airzone-sama/polargraph/wiki/images/setup tab.jpg

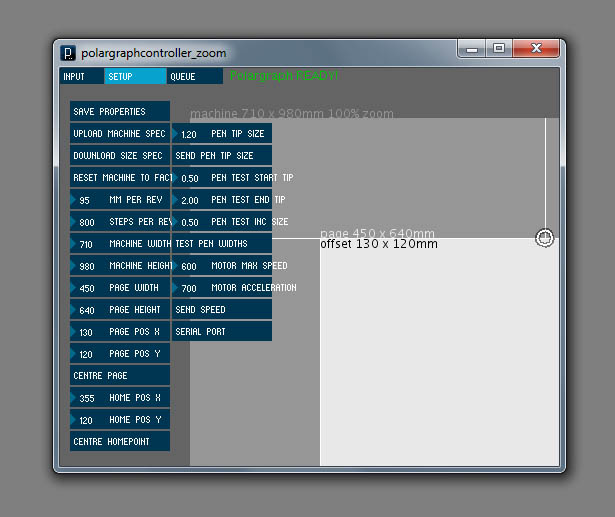
wiki/images/setup tab.jpg
