airzone-sama/polargraph/wiki/images/interface with labels.jpg

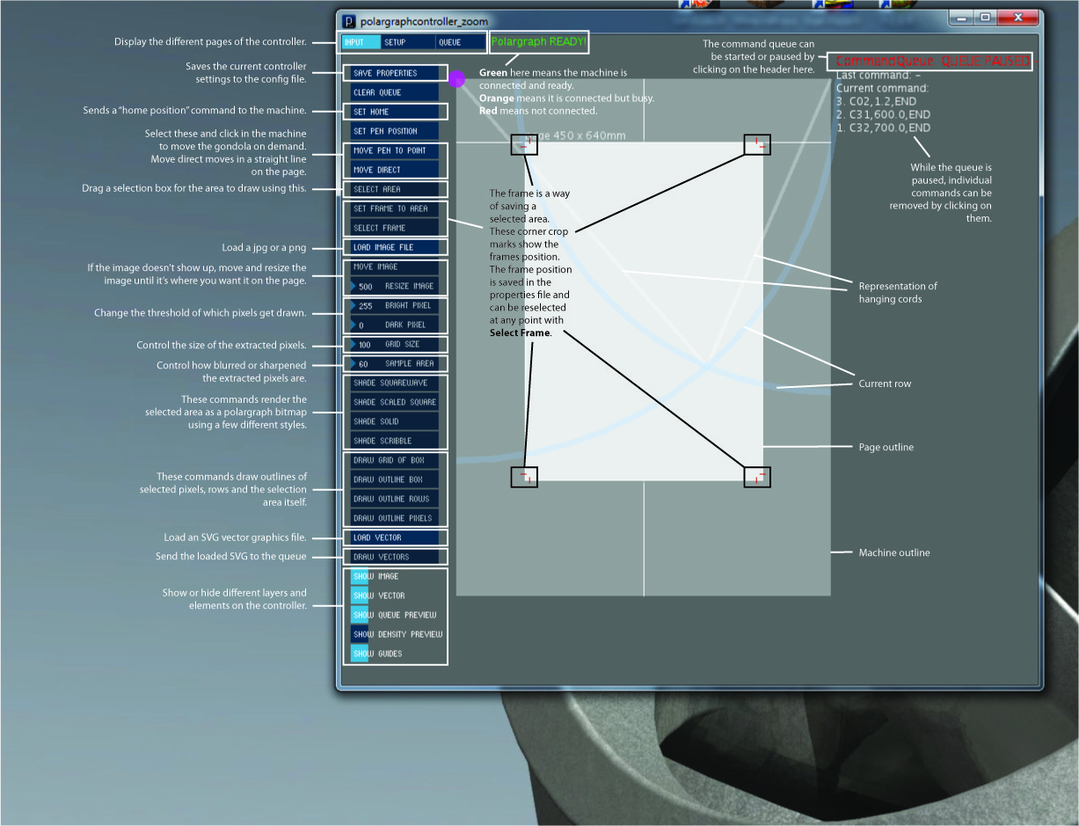
wiki/images/interface with labels.jpg
