airzone-sama/polargraph/hardware/polarshield v1.2 2012.11.02.htm

Partlist exported from C:/Users/sandy/Documents/eagle/Polarshield1.5/polarshield v1.2 2012.11.02.sch at 02/11/2012 22:22:55

Part | Value | Device | Package | Description
AUX3 | M04X2 | M04X2 | 2X4
C1 | 10uF | CPOL-EUCT3528 | CT3528 | POLARIZED CAPACITOR, European symbol
C2 | 100nF | C-EUC0805 | C0805 | CAPACITOR, European symbol
C3 | 100uF | CPOL-EU153CLV-0605 | 153CLV-0605 | POLARIZED CAPACITOR, European symbol
C4 | 100uF | CPOL-EU153CLV-0605 | 153CLV-0605 | POLARIZED CAPACITOR, European symbol
C5 | 10uF | CPOL-EUCT3528 | CT3528 | POLARIZED CAPACITOR, European symbol
C6 | 100uF | CPOL-EU153CLV-0605 | 153CLV-0605 | POLARIZED CAPACITOR, European symbol
C7 | 100nF | C-EUC0805 | C0805 | CAPACITOR, European symbol
CN1 | 1X4-CLEANBIG | 1X4-CLEANBIG | 1X04-CLEANBIG | 4-pin connector
CN2 | 1X4-CLEANBIG | 1X4-CLEANBIG | 1X04-CLEANBIG | 4-pin connector
D13 | | LEDCHIP-LED0805 | CHIP-LED0805 | LED
EXT_PWR | | JP1Q | JP1 | JUMPER
I2C | | PINHD-1X4 | 1X04 | PIN HEADER
IC1 | LMV358MMX | LMV358MMX | MSOP08 | Dual General Purpose, Low Voltage, Rail-to-Rail Output Operational Amplifiers
IC2 | MC33269D-3.3 | MC33269D-3.3 | DPACK | Adjustable Output Low Dropout Voltage Regulator 800 mA
J1 | 1X2-3.5MM | 1X2-3.5MM | 1X2-3.5MM | 3.5mm Terminal block
JP1 | | PINHD-1X8CLEANBIG | 1X08-CLEANBIG | PIN HEADER
JP2 | | M04SCREW | SCREWTERMINAL-3.5MM-4 | Header 4
JP3 | | PINHD-1X8CLEANBIG | 1X08-CLEANBIG | PIN HEADER
JP4 | | PINHD-2X3 | 2X03 | PIN HEADER
JP5 | | PINHD-2X3 | 2X03 | PIN HEADER
JP6 | | PINHD-2X20 | 2X20 | PIN HEADER
JP7 | | M04SCREW | SCREWTERMINAL-3.5MM-4 | Header 4
JP8 | | PINHD-1X8CLEANBIG | 1X08-CLEANBIG | PIN HEADER
JP9 | | PINHD-1X8CLEANBIG | 1X08-CLEANBIG | PIN HEADER
JP10 | | PINHD-1X8CLEANBIG | 1X08-CLEANBIG | PIN HEADER
JP11 | | PINHD-1X6CB | 1X06-CLEANBIG | PIN HEADER
JP12 | | PINHD-1X3CB | 1X03-CLEANBIG | PIN HEADER
JP13 | | PINHD-1X3CB | 1X03-CLEANBIG | PIN HEADER
JP14 | | PINHD-1X1CB | 1X01-CLEANBIG | Pin header 1x1 for 0.1" spacing
POWER | | LEDCHIP-LED0805 | CHIP-LED0805 | LED
PWR | RED | LEDCHIPLED_0805 | CHIPLED_0805 | LED
R1 | 10k | R-EU_R0805 | R0805 | RESISTOR, European symbol
R2 | 15k | R-EU_R0805 | R0805 | RESISTOR, European symbol
R5 | 100k | R-EU_R0805 | R0805 | RESISTOR, European symbol
R8 | 100k | R-EU_R0805 | R0805 | RESISTOR, European symbol
R12 | 1K | R-EU_R0805 | R0805 | RESISTOR, European symbol
R13 | 10 | R-EU_R0805 | R0805 | RESISTOR, European symbol
R18 | 10k | R-EU_R0805 | R0805 | RESISTOR, European symbol
R19 | 10k | R-EU_R0805 | R0805 | RESISTOR, European symbol
R21 | 4.7K | R-EU_R0805 | R0805 | RESISTOR, European symbol
R22 | 4.7K | R-EU_R0805 | R0805 | RESISTOR, European symbol
R26 | 10 | R-EU_R0805 | R0805 | RESISTOR, European symbol
R41 | 1K | R-EU_R0805 | R0805 | RESISTOR, European symbol
RN1 | 10K | 4R-NEXBS8V | EXBS8V | Array Chip Resistor
RN2 | 10K | 4R-NEXBS8V | EXBS8V | Array Chip Resistor
RN3 | 10K | 4R-NEXBS8V | EXBS8V | Array Chip Resistor
RN4 | 10K | 4R-NEXBS8V | EXBS8V | Array Chip Resistor
RN5 | 10K | 4R-NEXBS8V | EXBS8V | Array Chip Resistor
RN6 | 1K | 4R-NEXBS8V | EXBS8V | Array Chip Resistor
RSSI | YELLOW | LEDCHIPLED_0805 | CHIPLED_0805 | LED
RX | GRN | LEDCHIPLED_0805 | CHIPLED_0805 | LED
S2 | | TAC_SWITCHPTH | TACTILE-PTH | Momentary Switch
SER1 | | 3PIN-HEADER | 3PIN-HEADER | PIN HEADER
SER2 | | 3PIN-HEADER | 3PIN-HEADER | PIN HEADER
SW1 | JS202011AQN | JS202011AQN | JS202011AQN
TX | GRN | LEDCHIPLED_0805 | CHIPLED_0805 | LED
U$6 | A4988BREAKOUT | A4988BREAKOUT | A4988BREAKOUT
U$7 | A4988BREAKOUT | A4988BREAKOUT | A4988BREAKOUT
U1 | ARDUINO_MEGA_SHIELD | ARDUINO_MEGA_SHIELD | ARDUINO_MEGA_SHIELD
X+ | | 3PIN-HEADER | 3PIN-HEADER | PIN HEADER
X- | | 3PIN-HEADER | 3PIN-HEADER | PIN HEADER
X-MOT | | 1X4-BIG | 1X04-BIG | 4-pin connector
X1 | 2.1MMJACKTHM | 2.1MMJACKTHM | PJ-102A | 2.1mm x 5.5mm THM DC jack with internal switch. Digikey part #PJ-102A, 4UCON part #05537
XBEE | XBEE-1B2 | XBEE-1B2 | XBEE-SILK
Y+ | | 3PIN-HEADER | 3PIN-HEADER | PIN HEADER
Y- | | 3PIN-HEADER | 3PIN-HEADER | PIN HEADER
Y-MOT | | 1X4-BIG | 1X04-BIG | 4-pin connector
