airzone-sama/polargraph/ps2polar/one_motor_rev_diamond.jpg

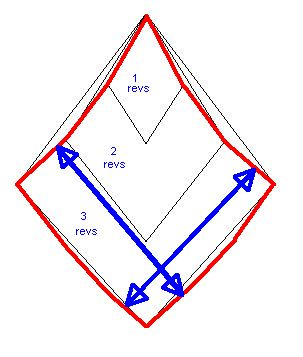
ps2polar/one_motor_rev_diamond.jpg
