airzone-sama/polargraph/ps2polar/string_art.jpg

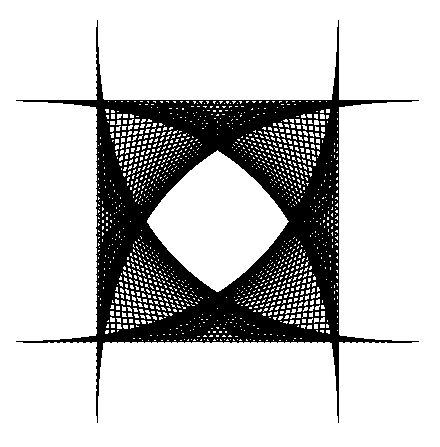
ps2polar/string_art.jpg
