airzone-sama/polargraph/wiki/images/change grid size during preview.jpg

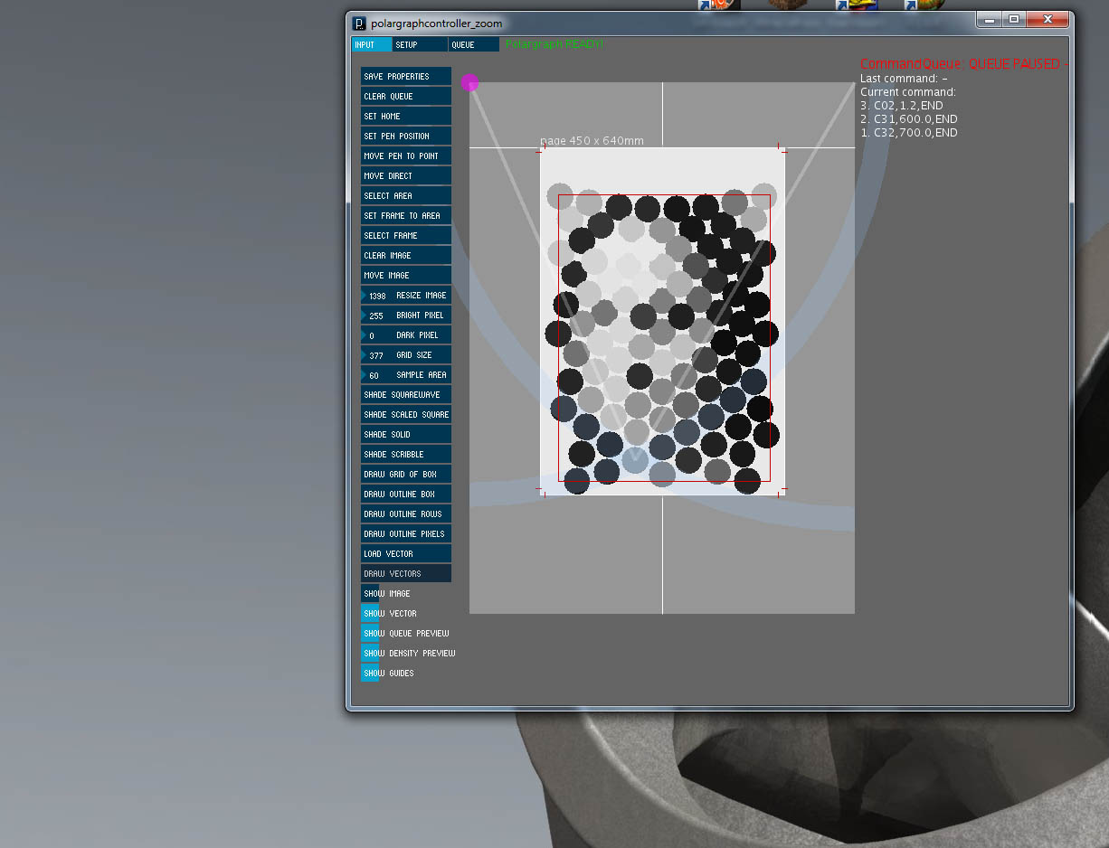
wiki/images/change grid size during preview.jpg
