airzone-sama/polargraph/wiki/images/change sample size during preview.jpg

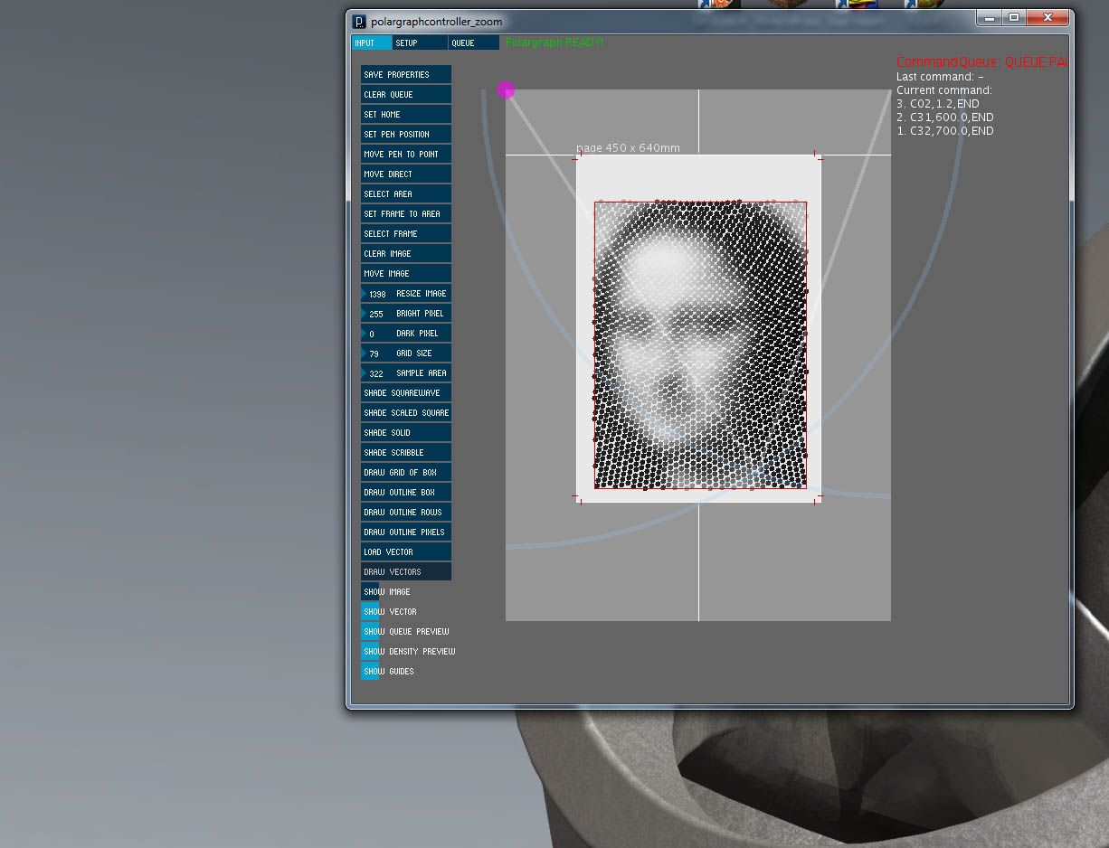
wiki/images/change sample size during preview.jpg
