airzone-sama/polargraph/wiki/images/change serial port.jpg

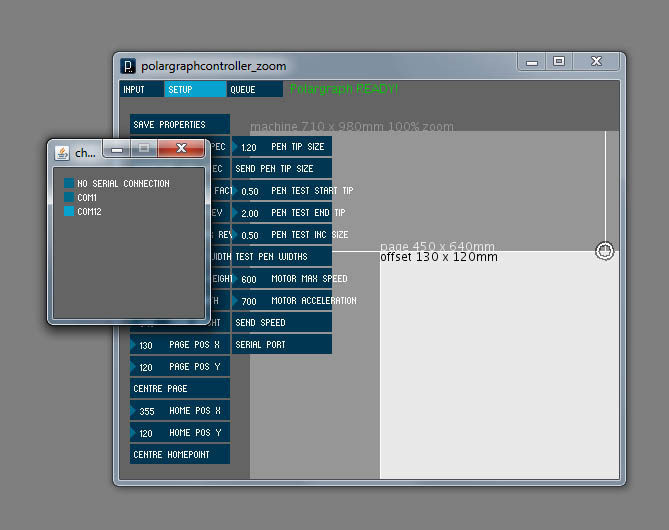
wiki/images/change serial port.jpg
