airzone-sama/polargraph/wiki/images/load vector graphics.jpg

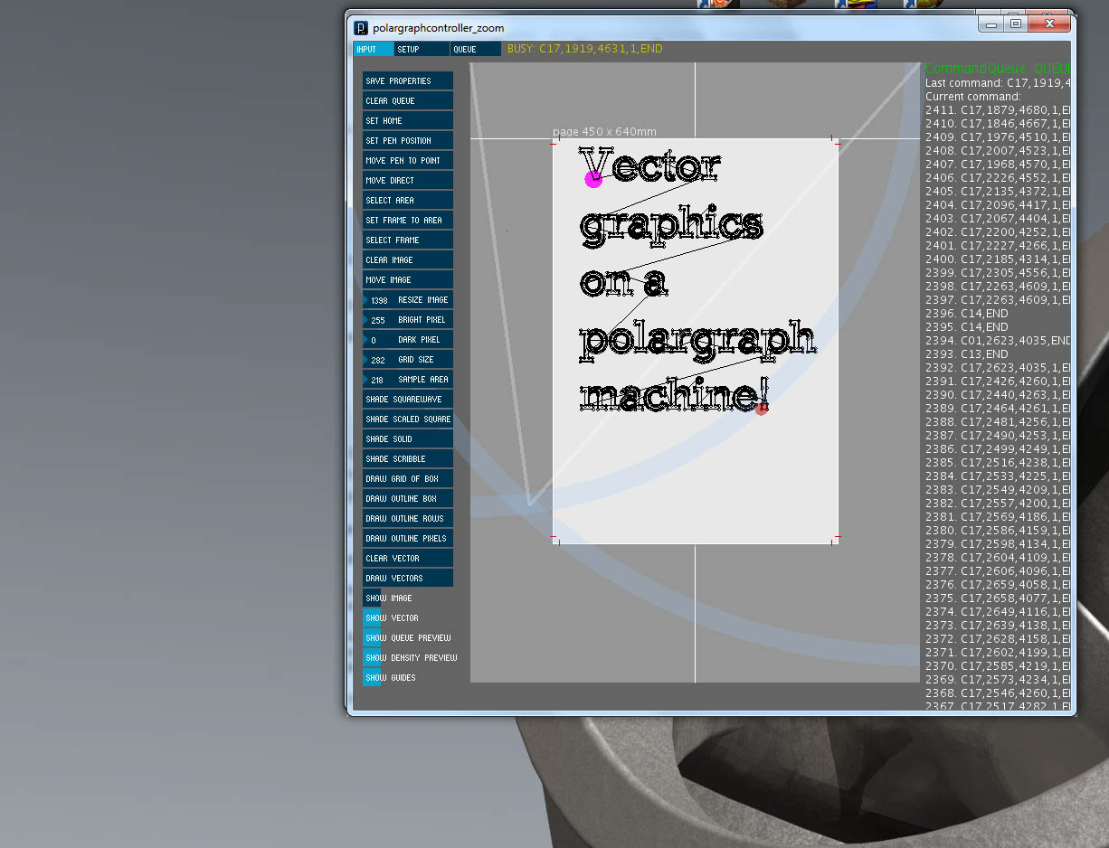
wiki/images/load vector graphics.jpg
