airzone-sama/polargraph/wiki/images/move image.jpg

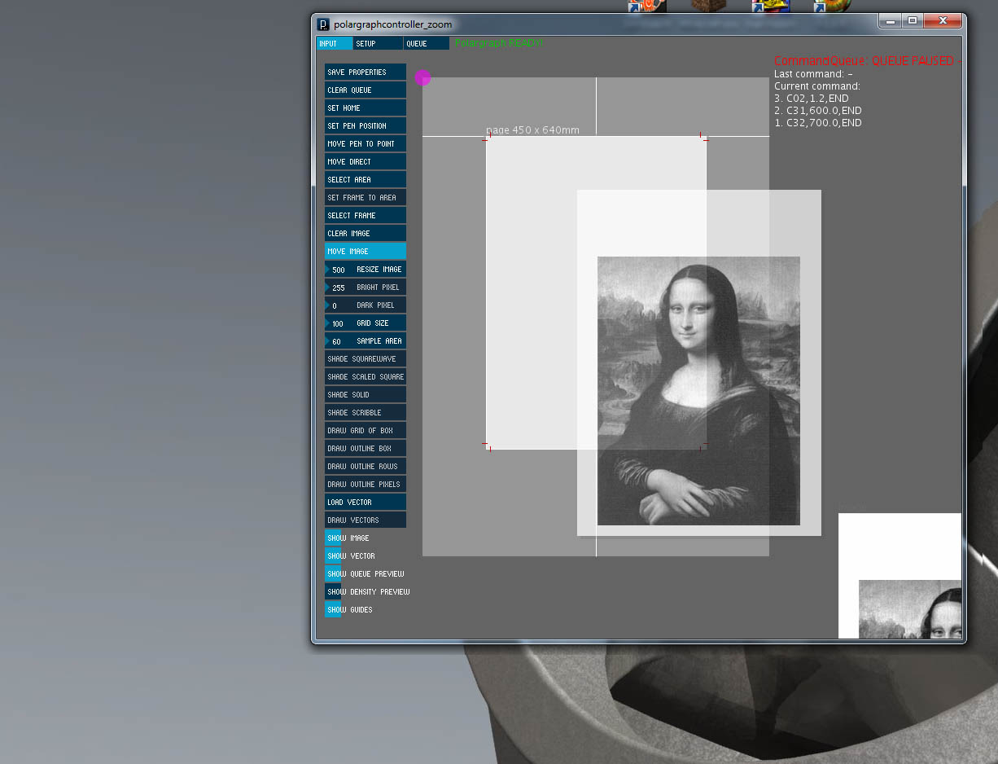
wiki/images/move image.jpg
