airzone-sama/polargraph/wiki/images/P1030602_c_r.jpg

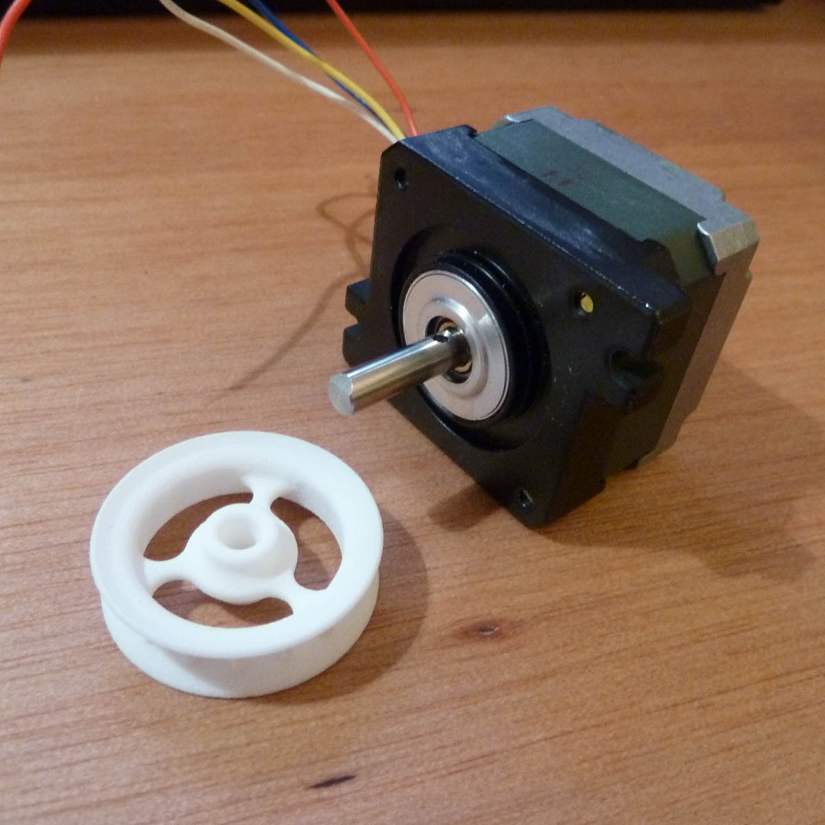
wiki/images/P1030602_c_r.jpg
