airzone-sama/polargraph/wiki/images/P1030603_c_r.jpg

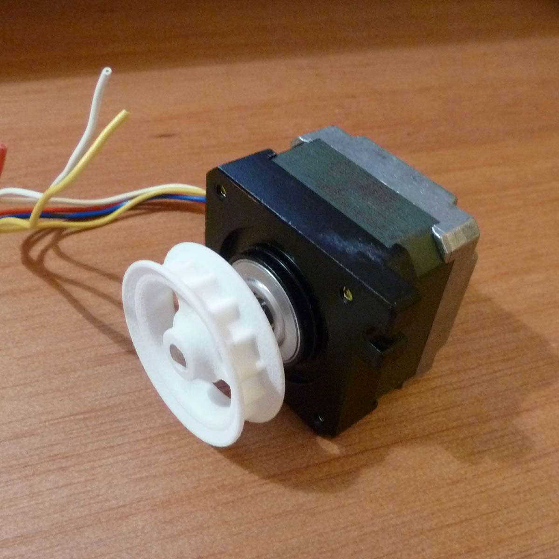
wiki/images/P1030603_c_r.jpg
