airzone-sama/polargraph/wiki/images/P1030609_c_p_r.jpg

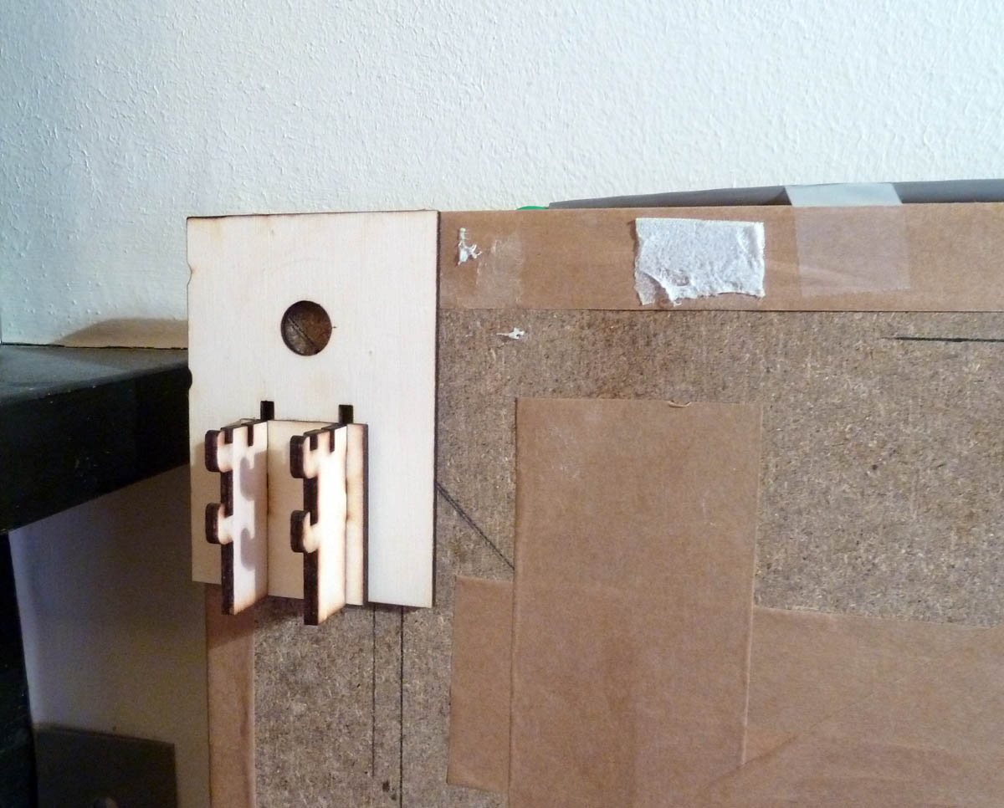
wiki/images/P1030609_c_p_r.jpg
