airzone-sama/polargraph/wiki/images/P1030670_c_r_p.jpg

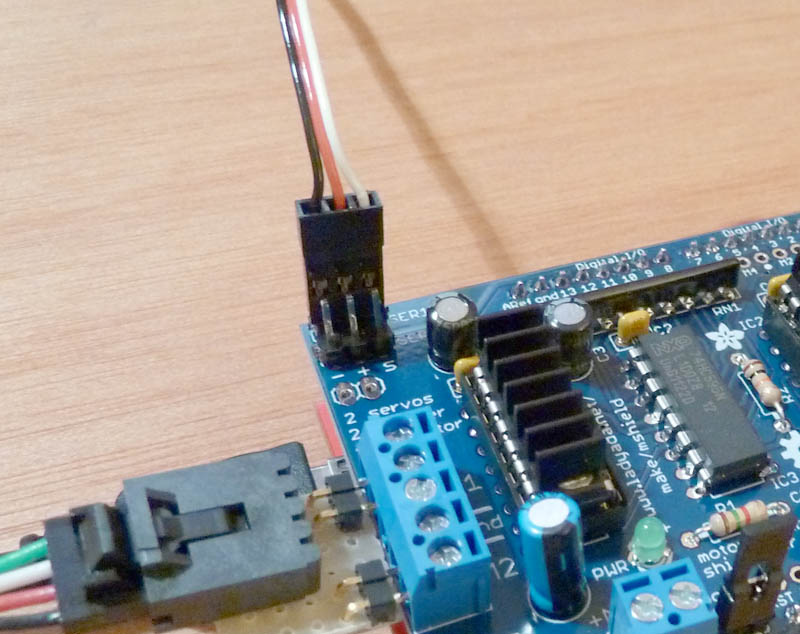
wiki/images/P1030670_c_r_p.jpg
