airzone-sama/polargraph/wiki/images/P1030677_c_p.jpg

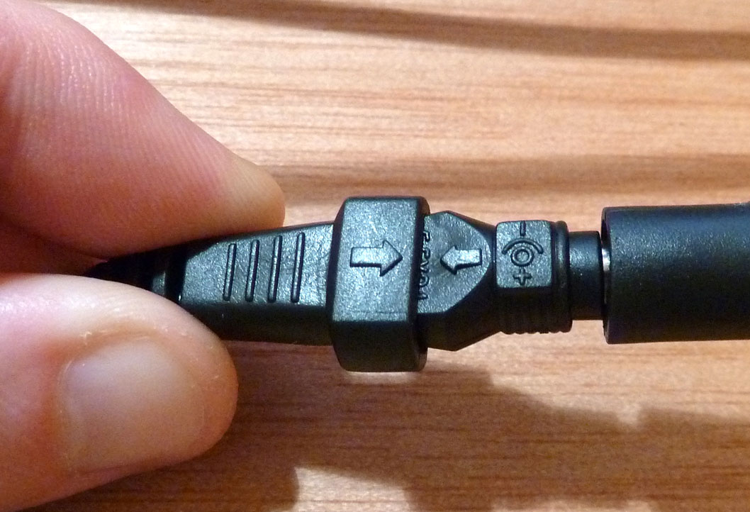
wiki/images/P1030677_c_p.jpg
