airzone-sama/polargraph/wiki/images/queue vector preview.jpg

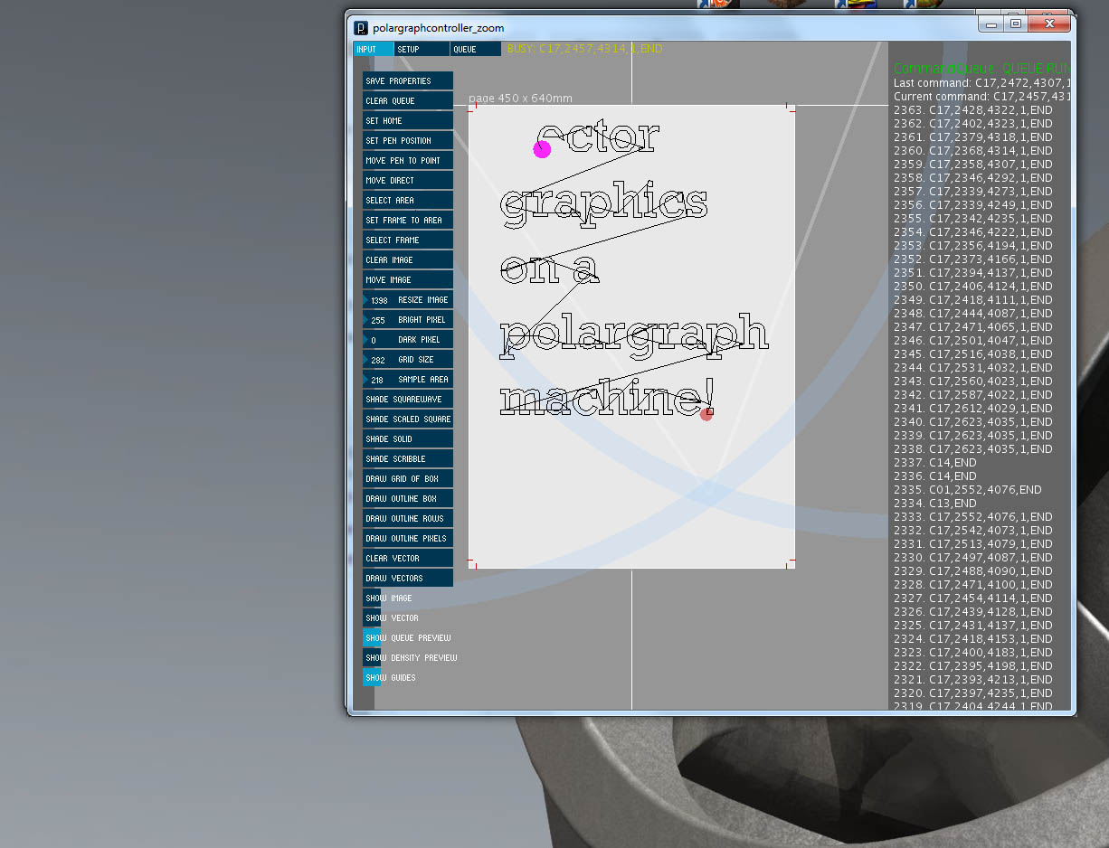
wiki/images/queue vector preview.jpg
