airzone-sama/polargraph/wiki/images/resize image during preview.jpg

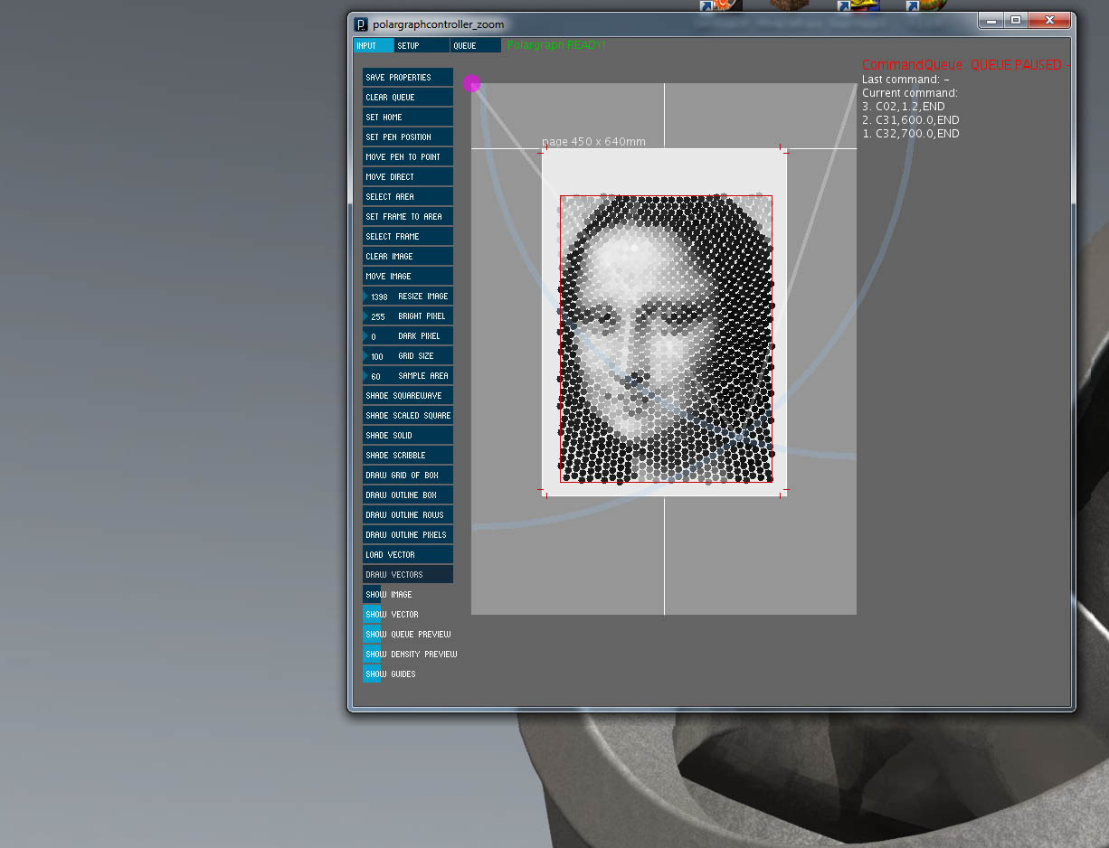
wiki/images/resize image during preview.jpg
