airzone-sama/polargraph/wiki/images/selected density preview.jpg

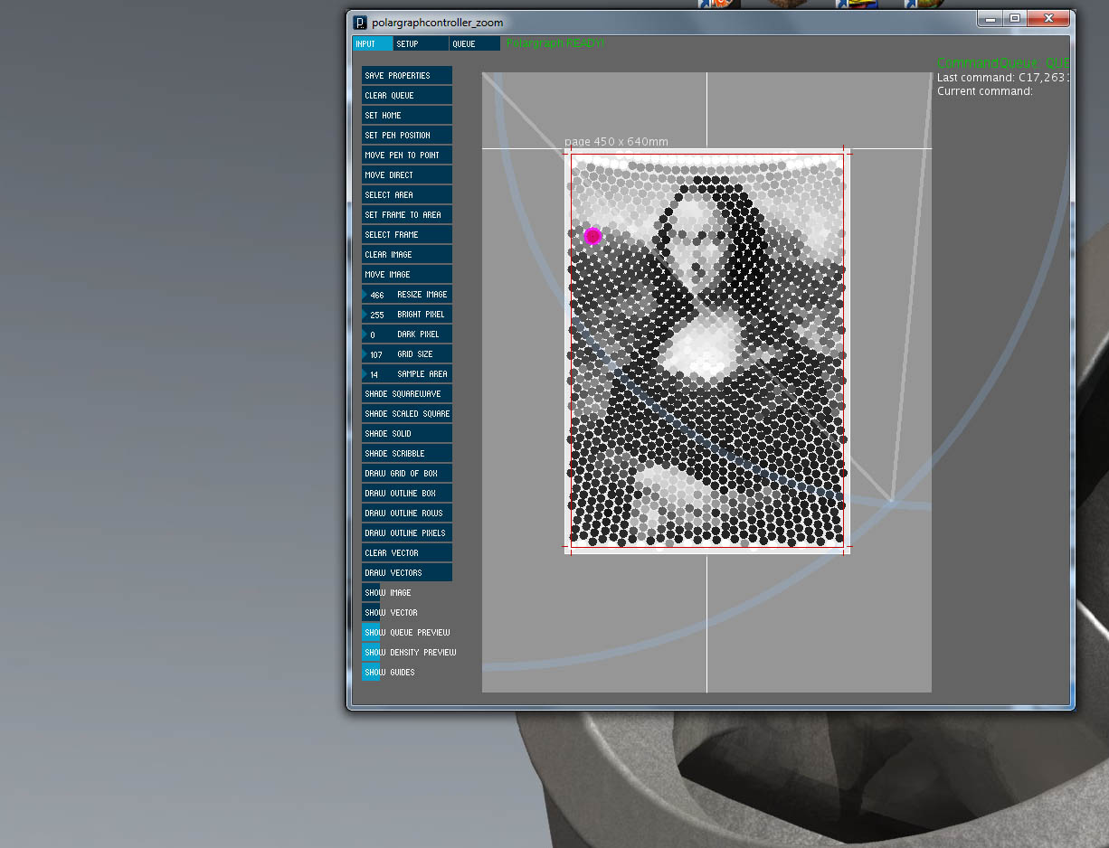
wiki/images/selected density preview.jpg
