airzone-sama/polargraph/wiki/images/startup app.jpg

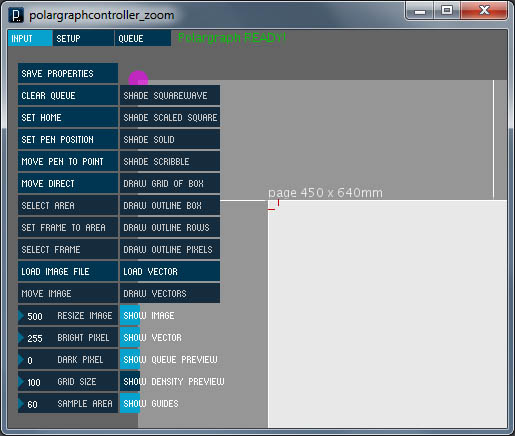
wiki/images/startup app.jpg
