airzone-sama/polargraph/wiki/SoftwareGuide.wiki

#summary How to use the controller software

= Introduction =

A quick guide about how to use the controller software.



= Details =

This is already covered in the instructable at http://www.instructables.com/id/Polargraph-Drawing-Machine/step12/Controller-software-Primer/ and the following steps.
