airzone-sama/polargraph/ps2polar/QA_show_origins_cmds.txt

C14,END
C01,7749,10257,END
C13,END
C01,7757,10239,END
C01,7764,10222,END
C01,7743,10209,END
C01,7723,10204,END
C01,7706,10206,END
C01,7696,10217,END
C01,7695,10234,END
C01,7702,10254,END
C01,7715,10274,END
C01,7735,10293,END
C01,7757,10305,END
C01,7777,10311,END
C01,7793,10308,END
C01,7803,10297,END
C01,7804,10280,END
C01,7797,10260,END
C01,7784,10240,END
C01,7764,10222,END
C14,END
C01,7326,9941,END
C13,END
C01,7334,9923,END
C01,7342,9905,END
C01,7320,9892,END
C01,7300,9888,END
C01,7284,9891,END
C01,7274,9902,END
C01,7272,9920,END
C01,7278,9940,END
C01,7291,9960,END
C01,7311,9978,END
C01,7333,9990,END
C01,7353,9995,END
C01,7369,9991,END
C01,7379,9980,END
C01,7381,9963,END
C01,7375,9943,END
C01,7361,9923,END
C01,7342,9905,END
C14,END
C01,2777,7271,END
C13,END
C01,2798,7246,END
C01,2819,7221,END
C01,2803,7220,END
C01,2783,7226,END
C01,2763,7240,END
C01,2744,7258,END
C01,2731,7279,END
C01,2725,7298,END
C01,2726,7312,END
C01,2736,7321,END
C01,2753,7322,END
C01,2772,7315,END
C01,2792,7302,END
C01,2811,7284,END
C01,2824,7263,END
C01,2830,7244,END
C01,2828,7230,END
C01,2819,7221,END
C14,END
C01,10325,7722,END
C13,END
C01,10343,7715,END
C01,10361,7708,END
C01,10343,7688,END
C01,10322,7674,END
C01,10302,7667,END
C01,10285,7669,END
C01,10274,7678,END
C01,10271,7694,END
C01,10276,7714,END
C01,10289,7736,END
C01,10307,7756,END
C01,10328,7770,END
C01,10348,7776,END
C01,10365,7775,END
C01,10376,7766,END
C01,10378,7750,END
C01,10373,7730,END
C01,10361,7708,END
C14,END
C01,10011,7297,END
C13,END
C01,10030,7290,END
C01,10048,7282,END
C01,10030,7263,END
C01,10010,7249,END
C01,9990,7242,END
C01,9973,7244,END
C01,9961,7254,END
C01,9958,7270,END
C01,9962,7291,END
C01,9974,7312,END
C01,9992,7332,END
C01,10012,7345,END
C01,10033,7352,END
C01,10050,7350,END
C01,10061,7340,END
C01,10065,7324,END
C01,10060,7304,END
C01,10048,7282,END
C14,END
C01,7366,2700,END
C13,END
C01,7391,2679,END
C01,7417,2659,END
C01,7408,2649,END
C01,7393,2647,END
C01,7374,2652,END
C01,7354,2666,END
C01,7335,2684,END
C01,7322,2705,END
C01,7315,2724,END
C01,7316,2740,END
C01,7325,2750,END
C01,7340,2752,END
C01,7358,2747,END
C01,7379,2734,END
C01,7397,2716,END
C01,7411,2696,END
C01,7417,2676,END
C01,7417,2659,END
C14,END
C01,7913,9908,END
C13,END
C01,7922,9891,END
C01,7931,9874,END
C01,7909,9861,END
C01,7889,9855,END
C01,7872,9857,END
C01,7861,9867,END
C01,7858,9883,END
C01,7864,9903,END
C01,7876,9924,END
C01,7895,9942,END
C01,7917,9956,END
C01,7937,9962,END
C01,7954,9960,END
C01,7965,9950,END
C01,7968,9933,END
C01,7962,9913,END
C01,7950,9893,END
C01,7931,9874,END
C14,END
C01,6824,3610,END
C13,END
C01,6849,3589,END
C01,6873,3569,END
C01,6862,3559,END
C01,6846,3557,END
C01,6827,3563,END
C01,6806,3576,END
C01,6789,3594,END
C01,6777,3615,END
C01,6772,3634,END
C01,6775,3650,END
C01,6786,3660,END
C01,6803,3662,END
C01,6822,3657,END
C01,6842,3644,END
C01,6860,3626,END
C01,6871,3605,END
C01,6876,3586,END
C01,6873,3569,END
C14,END
