airzone-sama/polargraph/ps2polar/QA_string_art_C17cmds.txt

C14,END
C17,4552,6090,20,END
C13,END
C17,6431,7597,20,END
C14,END
C17,4584,6113,20,END
C13,END
C17,6461,7560,20,END
C14,END
C17,4615,6137,20,END
C13,END
C17,6492,7522,20,END
C14,END
C17,4648,6161,20,END
C13,END
C17,6522,7485,20,END
C14,END
C17,4680,6186,20,END
C13,END
C17,6554,7448,20,END
C14,END
C17,4713,6211,20,END
C13,END
C17,6585,7411,20,END
C14,END
C17,4747,6237,20,END
C13,END
C17,6617,7375,20,END
C14,END
C17,4781,6262,20,END
C13,END
C17,6649,7338,20,END
C14,END
C17,4815,6288,20,END
C13,END
C17,6681,7302,20,END
C14,END
C17,4849,6315,20,END
C13,END
C17,6713,7266,20,END
C14,END
C17,4884,6342,20,END
C13,END
C17,6746,7230,20,END
C14,END
C17,4920,6369,20,END
C13,END
C17,6779,7194,20,END
C14,END
C17,4956,6397,20,END
C13,END
C17,6812,7159,20,END
C14,END
C17,4992,6425,20,END
C13,END
C17,6845,7124,20,END
C14,END
C17,5028,6453,20,END
C13,END
C17,6879,7089,20,END
C14,END
C17,5065,6482,20,END
C13,END
C17,6913,7054,20,END
C14,END
C17,5102,6511,20,END
C13,END
C17,6947,7019,20,END
C14,END
C17,5140,6541,20,END
C13,END
C17,6981,6985,20,END
C14,END
C17,5177,6570,20,END
C13,END
C17,7015,6950,20,END
C14,END
C17,5215,6600,20,END
C13,END
C17,7050,6916,20,END
C14,END
C17,5254,6631,20,END
C13,END
C17,7085,6882,20,END
C14,END
C17,5293,6661,20,END
C13,END
C17,7120,6849,20,END
C14,END
C17,5332,6692,20,END
C13,END
C17,7155,6815,20,END
C14,END
C17,5371,6724,20,END
C13,END
C17,7191,6782,20,END
C14,END
C17,5410,6755,20,END
C13,END
C17,7226,6749,20,END
C14,END
C17,5450,6787,20,END
C13,END
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
C14,END
C17,5114,6219,20,END
C13,END
C17,6794,7907,20,END
C14,END
C17,5074,6264,20,END
C13,END
C17,6840,7947,20,END
C14,END
C17,5035,6308,20,END
C13,END
C17,6887,7987,20,END
C14,END
C17,4995,6352,20,END
C13,END
C17,6933,8027,20,END
C14,END
C17,4956,6397,20,END
C13,END
C17,6980,8067,20,END
C14,END
