airzone-sama/polargraph/ps2polar/QA_string_art_cmds.txt

C14,END
C01,4552,6090,END
C13,END
C01,4576,6107,END
C01,4599,6125,END
C01,4622,6142,END
C01,4646,6160,END
C01,4670,6178,END
C01,4694,6197,END
C01,4719,6215,END
C01,4744,6234,END
C01,4768,6253,END
C01,4794,6272,END
C01,4819,6292,END
C01,4845,6311,END
C01,4870,6331,END
C01,4896,6351,END
C01,4923,6371,END
C01,4949,6392,END
C01,4976,6412,END
C01,5002,6433,END
C01,5029,6454,END
C01,5056,6475,END
C01,5084,6497,END
C01,5111,6518,END
C01,5139,6540,END
C01,5167,6562,END
C01,5195,6584,END
C01,5223,6606,END
C01,5251,6629,END
C01,5280,6651,END
C01,5309,6674,END
C01,5338,6697,END
C01,5367,6720,END
C01,5396,6744,END
C01,5425,6767,END
C01,5455,6791,END
C01,5484,6815,END
C01,5514,6839,END
C01,5544,6863,END
C01,5574,6887,END
C01,5604,6912,END
C01,5634,6936,END
C01,5665,6961,END
C01,5695,6986,END
C01,5726,7011,END
C01,5757,7036,END
C01,5788,7061,END
C01,5819,7087,END
C01,5850,7113,END
C01,5882,7138,END
C01,5913,7164,END
C01,5945,7190,END
C01,5976,7217,END
C01,6008,7243,END
C01,6040,7269,END
C01,6072,7296,END
C01,6104,7323,END
C01,6136,7350,END
C01,6169,7377,END
C01,6201,7404,END
C01,6233,7431,END
C01,6266,7458,END
C01,6299,7486,END
C01,6332,7513,END
C01,6364,7541,END
C01,6397,7569,END
C01,6431,7597,END
C14,END
C01,4584,6113,END
C13,END
C01,4608,6130,END
C01,4633,6148,END
C01,4657,6165,END
C01,4682,6183,END
C01,4708,6201,END
C01,4733,6219,END
C01,4759,6237,END
C01,4785,6256,END
C01,4811,6274,END
C01,4837,6293,END
C01,4864,6313,END
C01,4890,6332,END
C01,4917,6352,END
C01,4944,6372,END
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
C01,6464,7626,END
C01,6498,7654,END
C01,6532,7683,END
C01,6566,7712,END
C01,6600,7741,END
C01,6634,7770,END
C01,6668,7799,END
C01,6702,7829,END
C01,6737,7858,END
C01,6771,7888,END
C01,6806,7917,END
C01,6840,7947,END
C01,6875,7977,END
C01,6910,8007,END
C01,6945,8037,END
C01,6980,8067,END
C14,END
