airzone-sama/polargraph/ps2polar/QA_test_image_cmds.txt

C14,END
C08,A,LTR,END
C14,END
C01,5236,7306,END
C13,END
C05,5236,7306,50,0,END
C05,5289,7298,50,0,END
C05,5343,7290,50,255,END
C05,5396,7283,50,255,END
C05,5449,7276,50,255,END
C05,5503,7270,50,255,END
C05,5556,7264,50,255,END
C05,5610,7258,50,255,END
C05,5663,7253,50,255,END
C05,5716,7248,50,255,END
C05,5770,7243,50,255,END
C05,5823,7239,50,255,END
C05,5876,7235,50,255,END
C05,5930,7232,50,255,END
C05,5983,7229,50,255,END
C05,6037,7226,50,0,END
C14,END
C01,5228,7254,END
C13,END
C05,5228,7254,50,0,END
C05,5282,7246,50,0,END
C05,5335,7238,50,255,END
C05,5389,7231,50,238,END
C05,5442,7224,50,238,END
C05,5495,7217,50,238,END
C05,5549,7211,50,238,END
C05,5602,7205,50,238,END
C05,5656,7200,50,238,END
C05,5709,7195,50,238,END
C05,5762,7190,50,238,END
C05,5816,7186,50,238,END
C05,5869,7182,50,238,END
C05,5923,7179,50,238,END
C05,5976,7176,50,238,END
C05,6029,7173,50,238,END
C14,END
C01,5221,7202,END
C13,END
C05,5221,7202,50,221,END
C05,5275,7193,50,221,END
C05,5328,7186,50,221,END
C05,5381,7178,50,221,END
C05,5435,7171,50,221,END
C05,5488,7165,50,221,END
C05,5542,7158,50,221,END
C05,5595,7152,50,221,END
C05,5649,7147,50,221,END
C05,5702,7142,50,221,END
C05,5755,7137,50,221,END
C05,5809,7133,50,221,END
C05,5862,7129,50,221,END
C05,5916,7126,50,221,END
C05,5969,7123,50,221,END
C05,6023,7120,50,221,END
C14,END
C01,5215,7149,END
C13,END
C05,5215,7149,50,204,END
C05,5268,7141,50,204,END
C05,5321,7133,50,204,END
C05,5375,7126,50,204,END
C05,5428,7119,50,204,END
C05,5482,7112,50,204,END
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
C05,5338,6603,50,34,END
C05,5392,6595,50,34,END
C05,5445,6588,50,34,END
C05,5499,6580,50,34,END
C05,5552,6574,50,34,END
C05,5606,6567,50,34,END
C05,5659,6562,50,34,END
C05,5712,6556,50,34,END
C05,5766,6551,50,34,END
C05,5819,6547,50,34,END
C05,5873,6543,50,34,END
C05,5926,6539,50,34,END
C05,5980,6536,50,34,END
C14,END
C01,5177,6578,END
C13,END
C05,5177,6578,50,17,END
C05,5231,6568,50,17,END
C05,5284,6559,50,17,END
C05,5338,6551,50,17,END
C05,5391,6543,50,17,END
C05,5444,6535,50,17,END
C05,5498,6528,50,17,END
C05,5551,6521,50,17,END
C05,5605,6515,50,17,END
C05,5658,6509,50,17,END
C05,5712,6503,50,17,END
C05,5765,6498,50,17,END
C05,5818,6494,50,17,END
C05,5872,6490,50,17,END
C05,5925,6486,50,17,END
C05,5979,6483,50,17,END
C14,END
C01,5177,6526,END
C13,END
C05,5177,6526,50,0,END
C05,5231,6516,50,0,END
C05,5284,6507,50,0,END
C05,5337,6499,50,0,END
C05,5391,6491,50,0,END
C05,5444,6483,50,0,END
C05,5498,6476,50,0,END
C05,5551,6469,50,0,END
C05,5604,6462,50,0,END
C05,5658,6456,50,0,END
C05,5711,6451,50,0,END
C05,5765,6446,50,0,END
C05,5818,6441,50,0,END
C05,5871,6437,50,0,END
C05,5925,6433,50,0,END
C05,5978,6430,50,0,END
C14,END
