airzone-sama/polargraph/ps2polar/QA_test_text_cmds.txt

C14,END
C01,7486,9907,END
C13,END
C01,7482,9932,END
C01,7479,9957,END
C01,7488,9985,END
C01,7497,10014,END
C01,7518,10043,END
C01,7540,10073,END
C01,7571,10101,END
C01,7603,10130,END
C01,7637,10151,END
C01,7672,10172,END
C01,7702,10181,END
C01,7732,10190,END
C01,7755,10187,END
C01,7779,10184,END
C01,7793,10168,END
C01,7808,10152,END
C01,7812,10132,END
C01,7816,10111,END
C01,7810,10087,END
C01,7805,10064,END
C01,7787,10030,END
C01,7763,9995,END
C01,7732,9961,END
C01,7696,9931,END
C01,7661,9908,END
C01,7626,9886,END
C01,7595,9876,END
C01,7565,9867,END
C01,7541,9870,END
C01,7517,9873,END
C01,7501,9890,END
C01,7486,9907,END
C01,7486,9907,END
C14,END
C01,7520,9933,END
C13,END
C01,7532,9921,END
C01,7543,9909,END
C01,7580,9905,END
C01,7604,9913,END
C01,7628,9921,END
C01,7655,9939,END
C01,7683,9956,END
C01,7709,9978,END
C01,7731,10001,END
C01,7749,10023,END
C01,7763,10046,END
C01,7773,10068,END
C01,7778,10089,END
C01,7778,10108,END
C01,7774,10126,END
C01,7762,10137,END
C01,7751,10149,END
C01,7715,10152,END
C01,7692,10144,END
C01,7668,10137,END
C01,7641,10120,END
C01,7614,10103,END
C01,7589,10081,END
C01,7564,10058,END
C01,7548,10036,END
C01,7531,10013,END
C01,7516,9970,END
C01,7518,9951,END
C01,7520,9933,END
C01,7520,9933,END
C14,END
C01,7741,9885,END
C13,END
C01,7753,9862,END
C01,7764,9840,END
C01,7775,9818,END
C01,7786,9805,END
C01,7802,9803,END
C01,7822,9810,END
C01,7847,9828,END
C01,7874,9850,END
C01,7902,9870,END
C01,7927,9883,END
C01,7935,9868,END
C01,7943,9853,END
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
C01,8088,9282,END
C01,8131,9297,END
C01,8175,9313,END
C01,8218,9329,END
C01,8262,9345,END
C01,8271,9332,END
C01,8281,9319,END
C01,8245,9287,END
C01,8208,9255,END
C01,8172,9223,END
C01,8136,9191,END
C01,8100,9159,END
C01,8064,9127,END
C01,8028,9095,END
C01,7992,9063,END
C14,END
C01,8293,9302,END
