airzone-sama/polargraph/ps2polar/test_image.jpg

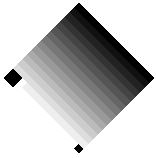
ps2polar/test_image.jpg
