airzone-sama/polargraph/embedded/polargraph_server_mega_buttons/polargraph_server_mega_buttons.ino

/**
*  Polargraph Server for ATMEGA1280+ based arduino boards
*  With the special hoofer doofer buttons pad on pins A5 and A6.

*  Written by Sandy Noble
*  Released under GNU License version 3.
*  http://www.polargraph.co.uk
*  http://code.google.com/p/polargraph/

2012-04-09 Added checksum as method of verifying serial comms.
*/

#include <AFMotor.h>
#include <AccelStepper.h>
#include <Servo.h>
#include <EEPROM.h>
#include <SD.h>
#include <Button.h>

// for working out CRCs
static PROGMEM prog_uint32_t crc_table[16] = {
    0x00000000, 0x1db71064, 0x3b6e20c8, 0x26d930ac,
    0x76dc4190, 0x6b6b51f4, 0x4db26158, 0x5005713c,
    0xedb88320, 0xf00f9344, 0xd6d6a3e8, 0xcb61b38c,
    0x9b64c2b0, 0x86d3d2d4, 0xa00ae278, 0xbdbdf21c
};
boolean usingCrc = false;


//  EEPROM addresses
const int EEPROM_MACHINE_WIDTH = 0;
const int EEPROM_MACHINE_HEIGHT = 2;
const int EEPROM_MACHINE_NAME = 4;
const int EEPROM_MACHINE_MM_PER_REV = 14;
const int EEPROM_MACHINE_STEPS_PER_REV = 16;

// Pen raising servo
Servo penHeight;
int const UP_POSITION = 180;
int const DOWN_POSITION = 90;
int const PEN_HEIGHT_SERVO_PIN = 10;
boolean isPenUp = true;

int const LED1_PIN = A2;
int const LED2_PIN = A1;
int const LED3_PIN = A3;

int const BUTTON1_PIN = A5;
int const BUTTON2_PIN = A4;

int button1State = 0;
int button2State = 0;

Button statusButton = Button(BUTTON1_PIN, BUTTON_PULLDOWN);
Button optionButton = Button(BUTTON2_PIN, BUTTON_PULLDOWN);

int motorStepsPerRev = 800;
float mmPerRev = 95;

int machineWidth = 650;
int machineHeight = 800;

const int DEFAULT_MACHINE_WIDTH = 650;
const int DEFAULT_MACHINE_HEIGHT = 650;
const int DEFAULT_MM_PER_REV = 95;
const int DEFAULT_STEPS_PER_REV = 800;

String machineName = "";
const String DEFAULT_MACHINE_NAME = "PG01    ";

float currentMaxSpeed = 800.0;
float currentAcceleration = 400.0;

float SUPERFAST_ACCELERATION = 6000;

AF_Stepper motora(motorStepsPerRev, 1);
AF_Stepper motorb(motorStepsPerRev, 2);

int startLengthMM = 800;

float mmPerStep = mmPerRev / motorStepsPerRev;
float stepsPerMM = motorStepsPerRev / mmPerRev;

long pageWidth = machineWidth * stepsPerMM;
long pageHeight = machineHeight * stepsPerMM;
long maxLength = 0;

static String rowAxis = "A";
const int INLENGTH = 50;
const char INTERMINATOR = 10;

const String DIRECTION_STRING_LTR = "LTR";
const int SRAM_SIZE = 2048;
const String FREE_MEMORY_STRING = "MEMORY,";
int availMem = 0;

static float penWidth = 0.8; // line width in mm

const int stepType = INTERLEAVE;

boolean reportingPosition = true;
boolean acceleration = true;

void forwarda() {  
  motora.onestep(FORWARD, stepType);
}
void backwarda() {  
  motora.onestep(BACKWARD, stepType);
}

AccelStepper accelA(forwarda, backwarda);


void forwardb() {  
  motorb.onestep(FORWARD, stepType);
}
void backwardb() {  
  motorb.onestep(BACKWARD, stepType);
}

AccelStepper accelB(forwardb, backwardb);

boolean currentlyRunning = false;

static String inCmd;
static String inParam1;
static String inParam2;
static String inParam3;
static String inParam4;

int inNoOfParams;

static boolean lastWaveWasTop = true;
static boolean lastMotorBiasWasA = true;
//static boolean drawingLeftToRight = true;

//  Drawing direction
const static byte DIR_NE = 1;
const static byte DIR_SE = 2;
const static byte DIR_SW = 3;
const static byte DIR_NW = 4;

const static byte DIR_N = 5;
const static byte DIR_E = 6;
const static byte DIR_S = 7;
const static byte DIR_W = 8;
static int globalDrawDirection = DIR_NW;

const static byte DIR_MODE_AUTO = 1;
const static byte DIR_MODE_PRESET = 2;
const static byte DIR_MODE_RANDOM = 3;
static int globalDrawDirectionMode = DIR_MODE_AUTO;


static int currentRow = 0;

const String READY = "READY_100";
const String RESEND = "RESEND";
const String DRAWING = "DRAWING";
const static String OUT_CMD_CARTESIAN = "CARTESIAN,";
const static String OUT_CMD_SYNC = "SYNC,";

static String readyString = READY;

String lastCommand = "";
boolean lastCommandConfirmed = false;

int roveMaxA = 0;
int roveMinA = 0;
int roveMaxB = 0;
int roveMinB = 0;

boolean roving = false;


const static String COMMA = ",";
const static String CMD_EXEC = "EXEC";
const static String CMD_ACK = "ACK,";

const static String CMD_CHANGELENGTH = "C01";
const static String CMD_CHANGEPENWIDTH = "C02";
const static String CMD_CHANGEMOTORSPEED = "C03";
const static String CMD_CHANGEMOTORACCEL = "C04";
const static String CMD_DRAWPIXEL = "C05";
const static String CMD_DRAWSCRIBBLEPIXEL = "C06";
const static String CMD_DRAWRECT = "C07";
const static String CMD_CHANGEDRAWINGDIRECTION = "C08";
const static String CMD_SETPOSITION = "C09";
const static String CMD_TESTPATTERN = "C10";
const static String CMD_TESTPENWIDTHSQUARE = "C11";
const static String CMD_TESTPENWIDTHSCRIBBLE = "C12";
const static String CMD_PENDOWN = "C13";
const static String CMD_PENUP = "C14";
const static String CMD_CHANGELENGTHDIRECT = "C17";
const static String CMD_SETMACHINESIZE = "C24";
const static String CMD_SETMACHINENAME = "C25";
const static String CMD_GETMACHINEDETAILS = "C26";
const static String CMD_RESETEEPROM = "C27";
const static String CMD_DRAWDIRECTIONTEST = "C28";
const static String CMD_SETMACHINEMMPERREV = "C29";
const static String CMD_SETMACHINESTEPSPERREV = "C30";
const static String CMD_SETMOTORSPEED = "C31";
const static String CMD_SETMOTORACCEL = "C32";
const static String CMD_MODE_STORE_COMMANDS = "C33";
const static String CMD_MODE_EXEC_FROM_STORE = "C34";
const static String CMD_MODE_LIVE = "C35";
const static String CMD_RANDOM_DRAW = "C36";

const static String CMD_END = ",END";

boolean storeCommands = false;
boolean drawFromStore = false;
String commandFilename = "commands.txt";

// sd card stuff
const int chipSelect = 53;
boolean sdCardInit = false;
// set up variables using the SD utility library functions:
Sd2Card card;
SdVolume volume;
SdFile root;


// This is stuff about the hardware controls (buttons etc)
const int CONTROL_SOURCE_USB = 0;
const int CONTROL_SOURCE_SD = 1;

int controlSource = CONTROL_SOURCE_USB;
boolean controlSourceChosen = true;
boolean hardwareCalibrated = false;
boolean hardwarePaused = true;

boolean led1State = HIGH;
boolean led2State = HIGH;
boolean led3State = HIGH;

const int LED_STATE_ON = 0;
const int LED_STATE_OFF = 1;
const int LED_STATE_FLASHING = 2;

int lastFlashTime = 0;
int FLASH_INTERVAL_SLOW = 300;

boolean restartExecFromStore = false;



void setup() 
{
  Serial.begin(57600);           // set up Serial library at 9600 bps
  Serial.print(F("POLARGRAPH ON!"));
  Serial.println();

  pinMode(LED1_PIN, OUTPUT);
  pinMode(LED2_PIN, OUTPUT);
  pinMode(LED3_PIN, OUTPUT);

  digitalWrite(LED1_PIN, led1State);
  digitalWrite(LED2_PIN, led2State);
  digitalWrite(LED3_PIN, led3State);

  pinMode(BUTTON1_PIN, INPUT);  
  pinMode(BUTTON2_PIN, INPUT);  

  // init SD card
  initSD();

  loadMachineSpecFromEeprom();

  accelA.setMaxSpeed(currentMaxSpeed);
  accelA.setAcceleration(currentAcceleration);  
  accelB.setMaxSpeed(currentMaxSpeed);
  accelB.setAcceleration(currentAcceleration);

  float startLength = ((float) startLengthMM / (float) mmPerRev) * (float) motorStepsPerRev;
  accelA.setCurrentPosition(startLength);
  accelB.setCurrentPosition(startLength);

  //testServoRange();
  movePenUp();

  readyString = READY;
  establishContact();
  delay(100);
  outputAvailableMemory();
}



void loadMachineSpecFromEeprom()
{
  machineWidth = EEPROMReadInt(EEPROM_MACHINE_WIDTH);
  if (machineWidth < 1)
  {
    machineWidth = DEFAULT_MACHINE_WIDTH;
  }
  Serial.print(F("Loaded machine width:"));
  Serial.println(machineWidth);
  
  machineHeight = EEPROMReadInt(EEPROM_MACHINE_HEIGHT);
  if (machineHeight < 1)
  {
    machineHeight = DEFAULT_MACHINE_HEIGHT;
  }
  Serial.print(F("Loaded machine height:"));
  Serial.println(machineHeight);

  mmPerRev = EEPROMReadInt(EEPROM_MACHINE_MM_PER_REV);
  if (mmPerRev < 1)
  {
    mmPerRev = DEFAULT_MM_PER_REV;
  }
  Serial.print(F("Loaded mm per rev:"));
  Serial.println(mmPerRev);

  motorStepsPerRev = EEPROMReadInt(EEPROM_MACHINE_STEPS_PER_REV);
  if (motorStepsPerRev < 1)
  {
    motorStepsPerRev = DEFAULT_STEPS_PER_REV;
  }
  Serial.print(F("Loaded motor steps per rev:"));
  Serial.println(motorStepsPerRev);

  mmPerStep = mmPerRev / motorStepsPerRev;
  stepsPerMM = motorStepsPerRev / mmPerRev;
  
  Serial.print(F("Recalculated mmPerStep ("));
  Serial.print(mmPerStep);
  Serial.print(F(") and stepsPerMM ("));
  Serial.print(stepsPerMM);
  Serial.print(F(")"));
  Serial.println();
  
  pageWidth = machineWidth * stepsPerMM;
  Serial.print(F("Recalculated pageWidth in steps ("));
  Serial.print(pageWidth);
  Serial.print(F(")"));
  Serial.println();
  pageHeight = machineHeight * stepsPerMM;
  Serial.print(F("Recalculated pageHeight in steps ("));
  Serial.print(pageHeight);
  Serial.print(F(")"));
  Serial.println();


  String name = "";
  for (int i = 0; i < 8; i++)
  {
    char b = EEPROM.read(EEPROM_MACHINE_NAME+i);
    name = name + b;
  }
  
  if (name[0] == 0)
    name = DEFAULT_MACHINE_NAME;
  
  machineName = name;
  Serial.print(F("Loaded machine name:"));
  Serial.println(machineName);
}


void penUp()
{
  if (isPenUp == false)
  {
    movePenUp();
  }
}

void movePenUp()
{
  penHeight.attach(PEN_HEIGHT_SERVO_PIN);
  for (int i=DOWN_POSITION; i<UP_POSITION; i++) {
//    Serial.println(i);
    penHeight.write(i);
    delay(10);
  }
  penHeight.detach();
  isPenUp = true;
}  


void penDown()
{
  if (isPenUp == true)
  {
    movePenDown();
  }
}
void movePenDown()
{
  penHeight.attach(PEN_HEIGHT_SERVO_PIN);
  for (int i=UP_POSITION; i>DOWN_POSITION; i--) {
//    Serial.println(i);
    penHeight.write(i);
    delay(5);
  }
  penHeight.detach();
  isPenUp = false;
}
void testPenHeight()
{
  delay(3000);
  penUp();
  delay(3000);
  penDown();
  delay(3000);
}
void testServoRange()
{
  penHeight.attach(PEN_HEIGHT_SERVO_PIN);
  for (int i=0; i<200; i++) {
    Serial.println(i);
    penHeight.write(i);
    delay(15);
  }
  penHeight.detach();
  
}
void establishContact() 
{
  ready();
}
void ready()
{
  Serial.println(READY);
}
void drawing()
{
  Serial.println(DRAWING);
}
void acknowledge(String command)
{
  Serial.print(CMD_ACK);
  Serial.println(command);
}


int toggleIndicator(int indicator)
{
  if (indicator == HIGH)
    indicator = LOW;
  else
    indicator = HIGH;
    
  return indicator;
}
void toggleIndicatorStates()
{
  led1State = toggleIndicator(led1State);
}

void writeIndicatorStates()
{
  digitalWrite(LED1_PIN, led1State);
  digitalWrite(LED2_PIN, led2State);
  digitalWrite(LED3_PIN, led3State);
}

void flashStatusLight()
{
  int timeSinceLastFlash = millis()-lastFlashTime;
  if (timeSinceLastFlash > FLASH_INTERVAL_SLOW)
  {
    toggleIndicatorStates();
    lastFlashTime = millis();
  }
}

void refreshIndicators()
{
  if (controlSourceChosen)
  {
    if (controlSource == CONTROL_SOURCE_USB)
    {
      led2State = HIGH;
      led3State = LOW;
    }
    else if (controlSource == CONTROL_SOURCE_SD)
    {
      led2State = LOW;
      led3State = HIGH;
    }
  }
  
  if (hardwareCalibrated)
  {
    if (hardwarePaused)
      flashStatusLight();
    else
      led1State = HIGH;
  }
  else // not calibrated
  {
    led1State = LOW;
  }

  writeIndicatorStates();
}

void checkButtons()
{
  boolean statusButtonWasPressed = statusButton.uniquePress();
  boolean optionButtonWasPressed = optionButton.uniquePress();
  
  if (statusButtonWasPressed && !optionButtonWasPressed)
  {
    statusButtonPressed();
    Serial.println(F("Status button uniquePress."));
  }
  else if (!statusButtonWasPressed && optionButtonWasPressed)
  {
    optionButtonPressed();
    Serial.println(F("Option button uniquePress."));
  }
  else if (statusButtonWasPressed && optionButtonWasPressed)
  {
    // both of them!! What does this mean!!!!!
    Serial.println("BOTH PRESSED!!");
  }
  
}

void statusButtonPressed()
{
  if (hardwareCalibrated && hardwarePaused)
  {
    hardwarePaused = false;
  }
  else if (hardwareCalibrated && !hardwarePaused)
  {
    // pause drawing
    hardwarePaused = true;
  }
  else if (!hardwareCalibrated)
  {
    // calibrate - set home using hardware
    inParam1 = "3340";
    inParam2 = "3332";
    setPosition(); // this sets calibrated to "true"
    hardwarePaused = true;
  }
}

void optionButtonPressed()
{
  if (!hardwarePaused || (hardwarePaused && !hardwareCalibrated))
  {
    Serial.println("Hardware not paused.  doing lift.");
    // currently running - toggle pen lift?
    if (isPenUp)
      penDown();
    else
      penUp();
  }
  else if (hardwarePaused && hardwareCalibrated)
  {
    Serial.println("Hardware paused.");
    // changing source
    if (controlSource == CONTROL_SOURCE_USB)
    {
      // reset command position
      controlSource = CONTROL_SOURCE_SD;
      restartExecFromStore = true;
      inParam1 = commandFilename;
    }
    else if (controlSource == CONTROL_SOURCE_SD)
    {
      controlSource = CONTROL_SOURCE_USB;
      restartExecFromStore = false;
    }
  }
}

void loop()
{
  
  checkButtons();
  refreshIndicators();
  
  // send ready
  // wait for instruction
  int idleTime = millis();
  while (!lastCommandConfirmed)
  {
    checkButtons();
    refreshIndicators();
//    rove();
    // idle
    String inS = "";

    // get incoming command
    while (inS.length() == 0)
    {
      checkButtons();
      refreshIndicators();
      if (!hardwarePaused && hardwareCalibrated && restartExecFromStore)
      {
        Serial.println("Exec from store now.");
        execFromStore();
        restartExecFromStore = false;
      }
//      rove();
      int timeSince = millis() - idleTime;
      if (timeSince > 5000)
      {
        ready();
        idleTime = millis();
      }
      inS = readCommand();
    }

    // if it's using the CRC check, then confirmation is easy
    if (usingCrc)
    {
      if (!lastCommandConfirmed)
      {
        requestResend();
      }
      else
      {
        lastCommand = inS;
      }
    }
    else
    {
      // not using CRCs.
  
      if (inS.equals(CMD_EXEC)) // this is confirming the previous command
      {
        // this shit is on
        lastCommandConfirmed = true;
        Serial.print(F("Command confirmed: "));
        Serial.println(lastCommand);
        idleTime = millis();
      }
      else if (inS.startsWith("CANCEL")) // this is cancelling the previous command
      {
        lastCommand = "";
        lastCommandConfirmed = false;
        ready();
        idleTime = millis();
      }
      else // new command
      {
        lastCommand = inS;
        lastCommandConfirmed = false;
        acknowledge(lastCommand);
        idleTime = millis();
      }
    }
  }

  boolean commandParsed = parseCommand(lastCommand);
  if (commandParsed)
  {
    // check for change mode commands
    if (lastCommand.startsWith(CMD_MODE_STORE_COMMANDS)
    || lastCommand.startsWith(CMD_MODE_LIVE))
    {
      Serial.println(F("Changing mode."));
      Serial.println(F("Executing command."));
      executeCommand(lastCommand);
    }
    // else execute / store the command
    else if (storeCommands)
    {
      Serial.print(F("Storing command:"));
      Serial.println(lastCommand);
      storeCommand(lastCommand);
    }
    else
    {
      Serial.println(F("Executing command."));
      executeCommand(lastCommand);
    }
    lastCommand = "";
    lastCommandConfirmed = false;
    ready();
  }
  else
  {
    Serial.println(F("Command not parsed."));
    lastCommand = "";
    lastCommandConfirmed = false;
    ready();
  }
}


void requestResend()
{
  Serial.println(RESEND);
}
String extractCommandFromExecute(String inS)
{
  String result = inS.substring(8);
  return result;
}


void executeCommand(String inS)
{
  outputAvailableMemory();

  if (inS.startsWith(CMD_CHANGELENGTH))
  {
    changeLength();
  }
  else if (inS.startsWith(CMD_CHANGELENGTHDIRECT))
  {
    changeLengthDirect();
  }
  else if (inS.startsWith(CMD_CHANGEPENWIDTH))
  {
    changePenWidth();
  }
  else if (inS.startsWith(CMD_CHANGEMOTORSPEED))
  {
    changeMotorSpeed();
  }
  else if (inS.startsWith(CMD_CHANGEMOTORACCEL))
  {
    changeMotorAcceleration();
  }
  else if (inS.startsWith(CMD_SETMOTORSPEED))
  {
    setMotorSpeed();
  }
  else if (inS.startsWith(CMD_SETMOTORACCEL))
  {
    setMotorAcceleration();
  }
  else if (inS.startsWith(CMD_DRAWPIXEL))
  {
    // go to coordinates.
    drawSquarePixel();
  }  
  else if (inS.startsWith(CMD_DRAWSCRIBBLEPIXEL))
  {
    // go to coordinates.
    drawScribblePixel();
  }  
  else if (inS.startsWith(CMD_DRAWRECT))
  {
    // go to coordinates.
    drawRectangle();
  }
  else if (inS.startsWith(CMD_CHANGEDRAWINGDIRECTION))
  {
    changeDrawingDirection();
  }
  else if (inS.startsWith(CMD_SETPOSITION))
  {
    setPosition();
  }
  else if (inS.startsWith(CMD_TESTPATTERN))
  {
    testPattern();
  }
  else if (inS.startsWith(CMD_TESTPENWIDTHSQUARE))
  {
    testPenWidth();
  }
  else if (inS.startsWith(CMD_TESTPENWIDTHSCRIBBLE))
  {
    testPenWidthScribble();
  }
  else if (inS.startsWith(CMD_PENDOWN))
  {
    penDown();
  }
  else if (inS.startsWith(CMD_PENUP))
  {
    penUp();
  }
  else if (inS.startsWith(CMD_SETMACHINESIZE))
  {
    setMachineSizeFromCommand();
  }
  else if (inS.startsWith(CMD_SETMACHINENAME))
  {
    setMachineNameFromCommand();
  }
  else if (inS.startsWith(CMD_SETMACHINEMMPERREV))
  {
    setMachineMmPerRevFromCommand();
  }
  else if (inS.startsWith(CMD_SETMACHINESTEPSPERREV))
  {
    setMachineStepsPerRevFromCommand();
  }
  else if (inS.startsWith(CMD_GETMACHINEDETAILS))
  {
    reportMachineSpec();
  }
  else if (inS.startsWith(CMD_RESETEEPROM))
  {
    resetEeprom();
  }
  else if (inS.startsWith(CMD_DRAWDIRECTIONTEST))
  {
    drawTestDirectionSquare();
  }
  else if (inS.startsWith(CMD_MODE_STORE_COMMANDS))
  {
    changeToStoreCommandMode();
  }
  else if (inS.startsWith(CMD_MODE_LIVE))
  {
    changeToLiveCommandMode();
  }
  else if (inS.startsWith(CMD_MODE_EXEC_FROM_STORE))
  {
    execFromStore();
  }
  else if (inS.startsWith(CMD_RANDOM_DRAW))
  {
    drawRandom();
  }
  else
  {
    Serial.print(F("Sorry, "));
    Serial.print(inS);
    Serial.print(F(" isn't a command I recognise."));
    Serial.println();
    ready();
  }

//  Serial.println("After execute:");
//  outputAvailableMemory();
  
}

boolean parseCommand(String inS)
{
  String endChars = inS.substring(inS.length() - 4);
  if (endChars.equals(CMD_END))
  {
    extractParams(inS);
    return true;
  }
  else
    return false;
}  

String readCommand()
{
  // check if data has been sent from the computer:
  char inString[INLENGTH+1];
  int inCount = 0;
  while (Serial.available() > 0)
  {
    char ch = Serial.read();       // get it
    delay(15);
    inString[inCount] = ch;
    if (ch == INTERMINATOR)
    {
      Serial.flush();
      break;
    }
    inCount++;
  }
  inString[inCount] = 0;                     // null terminate the string
  String inS = inString;

  // check the CRC for this command
  // and set commandConfirmed true or false
  int colonPos = inS.lastIndexOf(":");
  if (colonPos != -1)
  {
    usingCrc = true;
    String cs = inS.substring(colonPos+1);
    long checksum = asLong(cs);
    inS = inS.substring(0, colonPos);
    
    long calcCrc = crc_string(inS);
    
    if (calcCrc == checksum)
    {
      lastCommandConfirmed = true;
    }
    else
    {
      Serial.print(F("Checksum not matched!:"));
      Serial.println(calcCrc);
      lastCommandConfirmed = false;
    }
  }
  else
  {
    // then fall back and do the ACK - no action here
    usingCrc = false;
    lastCommandConfirmed = false;
  }

  return inS;
}

long asLong(String inParam)
{
  char paramChar[inParam.length() + 1];
  inParam.toCharArray(paramChar, inParam.length() + 1);
  return atol(paramChar);
}
int asInt(String inParam)
{
  char paramChar[inParam.length() + 1];
  inParam.toCharArray(paramChar, inParam.length() + 1);
  return atoi(paramChar);
}
byte asByte(String inParam)
{
  int i = asInt(inParam);
  return (byte) i;
}
float asFloat(String inParam)
{
  char paramChar[inParam.length() + 1];
  inParam.toCharArray(paramChar, inParam.length() + 1);
  return atof(paramChar);
}

/****************************************************************************************************************/
/****************************************************************************************************************/
/****************************************************************************************************************/
/****************************************************************************************************************/
/****************************            BELOW IS THE CODE THAT DOES THE WORK      ******************************/
/****************************************************************************************************************/
/****************************************************************************************************************/
/****************************************************************************************************************/
/****************************************************************************************************************/

void resetEeprom()
{
  for (int i = 0; i <20; i++)
  {
    EEPROM.write(i, 0);
  }
  loadMachineSpecFromEeprom();
}
void dumpEeprom()
{
  for (int i = 0; i <20; i++)
  {
    Serial.print(i);
    Serial.print(". ");
    Serial.println(EEPROM.read(i));
  }
}  

void drawRandom()
{
  for (int i = 0; i < 1000; i++)
  {
    Serial.print("Drawing:");
    Serial.println(i);
    while (accelA.distanceToGo() != 0 && accelB.distanceToGo() != 0)
    {
      accelA.run();
      accelB.run();
    }

    if (accelA.distanceToGo() == 0)
    {
      int r = random(-20,21);
      accelA.move(r);

      Serial.print("Chosen new A target: ");
      Serial.println(r);
    }

    if (accelB.distanceToGo() == 0)
    {
      int r = random(-20,21);
      accelB.move(r);
      Serial.print("Chosen new B target: ");
      Serial.println(r);
    }
    
    reportPosition();
  }
}

void execFromStore()
{
  String fileToExec = inParam1;
  if (fileToExec != "")
  {
    Serial.print(F("Filename to read from: "));
    Serial.println(fileToExec);
    commandFilename = fileToExec;
    char filename[commandFilename.length()+1];
    commandFilename.toCharArray(filename, commandFilename.length()+1);
    Serial.print(F("Array to read from: "));
    Serial.println(filename);
    File readFile = SD.open(filename, FILE_READ);
    if (readFile)
    {
      // the file could be found ok
      // switch to SD mode
      controlSource = CONTROL_SOURCE_SD;
      refreshIndicators();
      String command = "";
      while (readFile.available())
      {
        checkButtons();
        refreshIndicators();
        
        while (hardwarePaused)
        {
          checkButtons();
          refreshIndicators();
        }
        
        char ch = readFile.read();
        if (ch == 13)
        {
          // execute the line
          boolean commandParsed = parseCommand(command);
          Serial.print(F("Executing command "));
          Serial.println(command);
          executeCommand(command);
          command = "";
        }
        else if (ch == 10)
        {
//          Serial.println("lf");
        }
        else
          command += ch;
      }
      readFile.close();
    }
  }
  else
  {
    Serial.println(F("No filename supplied to read from."));
  }
  
  controlSource = CONTROL_SOURCE_USB;
}

void changeToStoreCommandMode()
{
  String newfilename = inParam1;
  String newFile = inParam2;
  if (newfilename != "")
  {
    Serial.print("Filename for command store: ");
    Serial.println(newfilename);
    storeCommands = true;
    commandFilename = newfilename;
    if (newFile.equals("R"))
    {
      // delete file if it exists
      char filename[newfilename.length()+1];
      newfilename.toCharArray(filename, newfilename.length()+1);
      
      if (SD.exists(filename))
      {
        // file exists
        Serial.println(F("File already exists."));
        boolean removed = SD.remove(filename);
        if (removed)
          Serial.println(F("File removed."));
        
      }
    }
  }
  else
  {
    Serial.println("No filename supplied to write to.");
  }
}

void changeToLiveCommandMode()
{
  Serial.println(F("Changing back to live mode."));
  storeCommands = false;
}

void reportMachineSpec()
{
  dumpEeprom();
  Serial.print(F("PGNAME,"));
  Serial.print(machineName);
  Serial.println(CMD_END);
  
  Serial.print(F("PGSIZE,"));
  Serial.print(machineWidth);
  Serial.print(COMMA);
  Serial.print(machineHeight);
  Serial.println(CMD_END);

  Serial.print(F("PGMMPERREV,"));
  Serial.print(mmPerRev);
  Serial.println(CMD_END);

  Serial.print(F("PGSTEPSPERREV,"));
  Serial.print(motorStepsPerRev);
  Serial.println(CMD_END);
}

void setMachineSizeFromCommand()
{
  int width = asLong(inParam1);
  int height = asLong(inParam2);
  
  if (width > 10)
  {
    EEPROMWriteInt(EEPROM_MACHINE_WIDTH, width);
  }
  if (height > 10)
  {
    EEPROMWriteInt(EEPROM_MACHINE_HEIGHT, height);
  }

  loadMachineSpecFromEeprom();
}
void setMachineNameFromCommand()
{
  String name = inParam1;
  if (name != DEFAULT_MACHINE_NAME)
  {
    for (int i = 0; i < 8; i++)
    {
      EEPROM.write(EEPROM_MACHINE_NAME+i, name[i]);
    }
  }
  loadMachineSpecFromEeprom();
}

void setMachineMmPerRevFromCommand()
{
  int mmPerRev = asInt(inParam1);
  EEPROMWriteInt(EEPROM_MACHINE_MM_PER_REV, mmPerRev);
  loadMachineSpecFromEeprom();
}
void setMachineStepsPerRevFromCommand()
{
  int stepsPerRev = asInt(inParam1);
  EEPROMWriteInt(EEPROM_MACHINE_STEPS_PER_REV, stepsPerRev);
  loadMachineSpecFromEeprom();
}

void setMotorSpeed()
{
  setMotorSpeed(asFloat(inParam1));
}

void setMotorSpeed(float speed)
{
  currentMaxSpeed = speed;
  accelA.setMaxSpeed(currentMaxSpeed);
  accelB.setMaxSpeed(currentMaxSpeed);
  Serial.print(F("New max speed: "));
  Serial.println(currentMaxSpeed);
}

void changeMotorSpeed()
{
  float speedChange = asFloat(inParam1);
  float newSpeed = currentMaxSpeed + speedChange;
  setMotorSpeed(newSpeed);
 }
 
void setMotorAcceleration()
{
  setMotorAcceleration(asFloat(inParam1));
}
void setMotorAcceleration(float accel)
{
  currentAcceleration = accel;
  accelA.setAcceleration(currentAcceleration);
  accelB.setAcceleration(currentAcceleration);
  Serial.print(F("New acceleration: "));
  Serial.println(currentAcceleration);
}
void changeMotorAcceleration()
{
  float speedChange = asFloat(inParam1);
  float newAccel = currentAcceleration + speedChange;
  setMotorAcceleration(newAccel);
}

void changePenWidth()
{
  penWidth = asFloat(inParam1);
  Serial.print(F("Changed Pen width to "));
  Serial.print(penWidth);
  Serial.print(F("mm"));
  Serial.println();
 }   

void changeDrawingDirection() 
{
  globalDrawDirectionMode = asInt(inParam1);
  globalDrawDirection = asInt(inParam2);
  Serial.print(F("Changed draw direction mode to be "));
  Serial.print(globalDrawDirectionMode);
  Serial.print(F(" and direction is "));
  Serial.println(globalDrawDirection);
}

  void extractParams(String inS) {
    
    // get number of parameters
    // by counting commas
    int length = inS.length();
    
    int startPos = 0;
    int paramNumber = 0;
    for (int i = 0; i < length; i++) {
      if (inS.charAt(i) == ',') {
        String param = inS.substring(startPos, i);
        startPos = i+1;
        
        switch(paramNumber) {
          case 0:
            inCmd = param;
            break;
          case 1:
            inParam1 = param;
            break;
          case 2:
            inParam2 = param;
            break;
          case 3:
            inParam3 = param;
            break;
          case 4:
            inParam4 = param;
            break;
          default:
            break;
        }
        paramNumber++;
      }
    }
    inNoOfParams = paramNumber;
    
//    Serial.print(F("Command:"));
//    Serial.print(inCmd);
//    Serial.print(F(", p1:"));
//    Serial.print(inParam1);
//    Serial.print(F(", p2:"));
//    Serial.print(inParam2);
//    Serial.print(F(", p3:"));
//    Serial.print(inParam3);
//    Serial.print(F(", p4:"));
//    Serial.println(inParam4);
  }
  
  void testPattern()
  {
    int rowWidth = asInt(inParam1);
    int noOfIncrements = asInt(inParam2);

    boolean ltr = true;
    
    for (int w = rowWidth; w < (w+(noOfIncrements*5)); w+=5)
    {
      for (int i = 0;  i <= maxDensity(penWidth, w); i++)
      {
        drawSquarePixel(w, w, i, ltr);
      }
      if (ltr)
        ltr = false;
      else
        ltr = true;
        
      moveB(w);
    }
  }
  
  void testPenWidth()
  {
    int rowWidth = asInt(inParam1);
    float startWidth = asFloat(inParam2);
    float endWidth = asFloat(inParam3); 
    float incSize = asFloat(inParam4);

    int tempDirectionMode = globalDrawDirectionMode;
    globalDrawDirectionMode = DIR_MODE_PRESET;
    
    float oldPenWidth = penWidth;
    int iterations = 0;
    
    for (float pw = startWidth; pw <= endWidth; pw+=incSize)
    {
      iterations++;
      penWidth = pw;
      int maxDens = maxDensity(penWidth, rowWidth);
      Serial.print(F("Penwidth test "));
      Serial.print(iterations);
      Serial.print(F(", pen width: "));
      Serial.print(penWidth);
      Serial.print(F(", max density: "));
      Serial.println(maxDens);
      drawSquarePixel(rowWidth, rowWidth, maxDens, DIR_SE);
    }

    penWidth = oldPenWidth;
    
    moveB(0-rowWidth);
    for (int i = 1; i <= iterations; i++)
    {
      moveB(0-(rowWidth/2));
      moveA(0-rowWidth);
      moveB(rowWidth/2);
    }
    
    penWidth = oldPenWidth;
    globalDrawDirectionMode = tempDirectionMode;
  }    

  void testPenWidthScribble()
  {
    int rowWidth = asInt(inParam1);
    float startWidth = asFloat(inParam2);
    float endWidth = asFloat(inParam3); 
    float incSize = asFloat(inParam4);
    
    boolean ltr = true;
    
    float oldPenWidth = penWidth;
    int iterations = 0;
    
    int posA = accelA.currentPosition();
    int posB = accelB.currentPosition();

    int startColumn = posA;
    int startRow = posB;
    
    for (float pw = startWidth; pw <= endWidth; pw+=incSize)
    {
      iterations++;
      int column = posA;
      
      penWidth = pw;
      int maxDens = maxDensity(penWidth, rowWidth);
      Serial.print(F("Penwidth test "));
      Serial.print(iterations);
      Serial.print(F(", pen width: "));
      Serial.print(penWidth);
      Serial.print(F(", max density: "));
      Serial.println(maxDens);
      
      for (int density = maxDens; density >= 0; density--)
      {
        drawScribblePixel(posA, posB, rowWidth, density);
        posB+=rowWidth;
      }
      
      posA+=rowWidth;
      posB = startRow;
    }
    
    changeLength(long(posA-(rowWidth/2)), long(startRow-(rowWidth/2)));

    penWidth = oldPenWidth;
    
    moveB(0-rowWidth);
    for (int i = 1; i <= iterations; i++)
    {
      moveB(0-(rowWidth/2));
      moveA(0-rowWidth);
      moveB(rowWidth/2);
    }
    
    penWidth = oldPenWidth;
  }    

  void drawRectangle()
  {
//    int v1A = asInt(inParam1);
//    int v1B = asInt(inParam2);
//    int v2A = asInt(inParam3);
//    int v2B = asInt(inParam4);
//    
//    changeLength(v1A, v1B);
//    accelA.moveTo(v2A);
//    accelA.runToPosition();
//    
//    accelB.moveTo(v2B);
//    accelB.runToPosition();
//    
//    accelA.moveTo(v1A);
//    accelA.runToPosition();
//    
//    accelB.moveTo(v1B);
//    accelB.runToPosition();
    
  }

//float rads(int n) {
//  // Return an angle in radians
//  return (n/180.0 * PI);
//}    
//
//void drawCurve(float x, float y, float fx, float fy, float cx, float cy) {
//  // Draw a Quadratic Bezier curve from (x, y) to (fx, fy) using control pt
//  // (cx, cy)
//  float xt=0;
//  float yt=0;
//
//  for (float t=0; t<=1; t+=.0025) {
//    xt = pow((1-t),2) *x + 2*t*(1-t)*cx+ pow(t,2)*fx;
//    yt = pow((1-t),2) *y + 2*t*(1-t)*cy+ pow(t,2)*fy;
//    changeLength(xt, yt);
//  }  
//}
//                                                     
//
//void drawCircle(int centerx, int centery, int radius) {
//  // Estimate a circle using 20 arc Bezier curve segments
//  int segments =20;
//  int angle1 = 0;
//  int midpoint=0;
//   
//   changeLength(centerx+radius, centery);
//
//  for (float angle2=360/segments; angle2<=360; angle2+=360/segments) {
//
//    midpoint = angle1+(angle2-angle1)/2;
//
//    float startx=centerx+radius*cos(rads(angle1));
//    float starty=centery+radius*sin(rads(angle1));
//    float endx=centerx+radius*cos(rads(angle2));
//    float endy=centery+radius*sin(rads(angle2));
//    
//    int t1 = rads(angle1)*1000 ;
//    int t2 = rads(angle2)*1000;
//    int t3 = angle1;
//    int t4 = angle2;
//
//    drawCurve(startx,starty,endx,endy,
//              centerx+2*(radius*cos(rads(midpoint))-.25*(radius*cos(rads(angle1)))-.25*(radius*cos(rads(angle2)))),
//              centery+2*(radius*sin(rads(midpoint))-.25*(radius*sin(rads(angle1)))-.25*(radius*sin(rads(angle2))))
//    );
//    
//    angle1=angle2;
//  }
//
//}
//
//
//              
//void drawCircles(int number, int centerx, int centery, int r) {
//   // Draw a certain number of concentric circles at the given center with
//   // radius r
//   int dr=0;
//   if (number > 0) {
//     dr = r/number;
//     for (int k=0; k<number; k++) {
//       drawCircle(centerx, centery, r);
//       r=r-dr;
//     }
//   }
//}



void changeLength()
{
  long lenA = asLong(inParam1);
  long lenB = asLong(inParam2);
  
  changeLength(lenA, lenB);
}  

void changeLength(long tA, long tB)
{
  accelA.moveTo(tA);
  accelB.moveTo(tB);
  
  while (accelA.distanceToGo() != 0 || accelB.distanceToGo() != 0)
  {
//    refreshIndicators();
    accelA.run();
    accelB.run();
  }
  
  reportPosition();
}

void changeLength(float tA, float tB)
{
//  int intPos = (int)(tA+0.5);
//  accelA.moveTo(intPos);
//  intPos = (int)(tB+0.5);
//  accelB.moveTo(intPos);

  accelA.moveTo(tA);
  accelB.moveTo(tB);
  
  while (accelA.distanceToGo() != 0 || accelB.distanceToGo() != 0)
  {
//    refreshIndicators();
    accelA.run();
    accelB.run();
  }
  
  reportPosition();
}

void changeLengthRelative(long tA, long tB)
{
  accelA.move(tA);
  accelB.move(tB);
  
  while (accelA.distanceToGo() != 0 || accelB.distanceToGo() != 0)
  {
//    refreshIndicators();
    accelA.run();
    accelB.run();
  }
  
  reportPosition();
}

long getMaxLength()
{
  if (maxLength == 0)
  {
    float length = getMachineA(machineWidth * stepsPerMM, machineHeight * stepsPerMM);
    maxLength = long(length+0.5);
  }
  return maxLength;
}


void changeLengthDirect()
{
  float endA = asFloat(inParam1);
  float endB = asFloat(inParam2);
  int maxSegmentLength = asInt(inParam3);

  float startA = accelA.currentPosition();
  float startB = accelB.currentPosition();
//  Serial.println(F("Drawing direct line"));

  if (endA < 20 || endB < 20 || endA > getMaxLength() | endB > getMaxLength())
  {
    Serial.println("This point falls outside the area of this machine. Skipping it.");
  }
  else
  {
    drawBetweenPoints(startA, startB, endA, endB, maxSegmentLength);
  }
}  

/**
Thanks to Andy Kinsman for help with this method.

This moves the gondola in a straight line between p1 and p2.  Both input coordinates are in 
the native coordinates system.  

The fidelity of the line is controlled by maxLength - this is the longest size a line segment is 
allowed to be.  1 is finest, slowest.  Use higher values for faster, wobblier.
*/
void drawBetweenPoints(float p1a, float p1b, float p2a, float p2b, int maxSegmentLength)
{
  // ok, we're going to plot some dots between p1 and p2.  Using maths. I know! Brave new world etc.
  
  reportingPosition = false;
  
  // First, convert these values to cartesian coordinates
  // We're going to figure out how many segments the line
  // needs chopping into.
  float c1x = getCartesianXFP(p1a, p1b);
  float c1y = getCartesianYFP(c1x, p1a);
  
  float c2x = getCartesianXFP(p2a, p2b);
  float c2y = getCartesianYFP(c2x, p2a);
  
  // test to see if it's on the page
  if (c2x > 20 && c2x<pageWidth-20 && c2y > 20 && c2y <pageHeight-20)
  {
    float deltaX = c2x-c1x;    // distance each must move (signed)
    float deltaY = c2y-c1y;
  
    int linesegs = 1;            // assume at least 1 line segment will get us there.
    if (abs(deltaX) > abs(deltaY))
    {
      // slope <=1 case    
      while ((abs(deltaX)/linesegs) > maxSegmentLength)
      {
        linesegs++;
      }
    }
    else
    {
      // slope >1 case
      while ((abs(deltaY)/linesegs) > maxSegmentLength)
      {
        linesegs++;
      }
    }
    
    // reduce delta to one line segments' worth.
    deltaX = deltaX/linesegs;
    deltaY = deltaY/linesegs;
  
    // render the line in N shorter segments
    while (linesegs > 0)
    {
      // compute next new location
      c1x = c1x + deltaX;
      c1y = c1y + deltaY;
  
      // convert back to machine space
      float pA = getMachineA(c1x, c1y);
      float pB = getMachineB(c1x, c1y);
    
      // do the move
      useAcceleration(false);
      changeLength(pA, pB);
  
      // one line less to do!
      linesegs--;
    }
    
    // do the end point in case theres been some rounding errors etc
    reportingPosition = true;
    changeLength(p2a, p2b);
    useAcceleration(true);
  }
  else
  {
    Serial.println("Line is not on the page. Skipping it.");
  }
  outputAvailableMemory();
}

void useAcceleration(boolean use)
{
  if (use)
  {
    accelA.setAcceleration(currentAcceleration);
    accelB.setAcceleration(currentAcceleration);
  }
  else
  {
    accelA.setAcceleration(SUPERFAST_ACCELERATION);
    accelB.setAcceleration(SUPERFAST_ACCELERATION);
  }
}


float getMachineA(float cX, float cY)
{
  float a = sqrt(sq(cX)+sq(cY));
  return a;
}
float getMachineB(float cX, float cY)
{
  float b = sqrt(sq((pageWidth)-cX)+sq(cY));
  return b;
}



void drawTestDirectionSquare()
{
  int rowWidth = asInt(inParam1);
  int segments = asInt(inParam2);
  drawSquarePixel(rowWidth, rowWidth, segments, DIR_SE);
  moveA(rowWidth*2);
  
  drawSquarePixel(rowWidth, rowWidth, segments, DIR_SW);
  moveB(rowWidth*2);
  
  drawSquarePixel(rowWidth, rowWidth, segments, DIR_NW);
  moveA(0-(rowWidth*2));
  
  drawSquarePixel(rowWidth, rowWidth, segments, DIR_NE);
  moveB(0-(rowWidth*2));
  
}

void drawSquarePixel() 
{
    long originA = asLong(inParam1);
    long originB = asLong(inParam2);
    int size = asInt(inParam3);
    int density = asInt(inParam4);

    int halfSize = size / 2;
    
    long startPointA;
    long startPointB;
    long endPointA;
    long endPointB;

    int calcFullSize = halfSize * 2; // see if there's any rounding errors
    int offsetStart = size - calcFullSize;
    
    if (globalDrawDirectionMode == DIR_MODE_AUTO)
      globalDrawDirection = getAutoDrawDirection(originA, originB, accelA.currentPosition(), accelB.currentPosition());
      

    if (globalDrawDirection == DIR_SE) 
    {
//      Serial.println(F("d: SE"));
      startPointA = originA - halfSize;
      startPointA += offsetStart;
      startPointB = originB;
      endPointA = originA + halfSize;
      endPointB = originB;
    }
    else if (globalDrawDirection == DIR_SW)
    {
//      Serial.println(F("d: SW"));
      startPointA = originA;
      startPointB = originB - halfSize;
      startPointB += offsetStart;
      endPointA = originA;
      endPointB = originB + halfSize;
    }
    else if (globalDrawDirection == DIR_NW)
    {
//      Serial.println(F("d: NW"));
      startPointA = originA + halfSize;
      startPointA -= offsetStart;
      startPointB = originB;
      endPointA = originA - halfSize;
      endPointB = originB;
    }
    else //(drawDirection == DIR_NE)
    {
//      Serial.println(F("d: NE"));
      startPointA = originA;
      startPointB = originB + halfSize;
      startPointB -= offsetStart;
      endPointA = originA;
      endPointB = originB - halfSize;
    }

    density = scaleDensity(density, 255, maxDensity(penWidth, size));
//    Serial.print(F("Start point: "));
//    Serial.print(startPointA);
//    Serial.print(COMMA);
//    Serial.print(startPointB);
//    Serial.print(F(". end point: "));
//    Serial.print(endPointA);
//    Serial.print(COMMA);
//    Serial.print(endPointB);
//    Serial.println(F("."));
    
    changeLength(startPointA, startPointB);
    if (density > 1)
    {
      drawSquarePixel(size, size, density, globalDrawDirection);
    }
    changeLength(endPointA, endPointB);
    
    outputAvailableMemory(); 
}

byte getRandomDrawDirection()
{
  return random(1, 5);
}

byte getAutoDrawDirection(long targetA, long targetB, long sourceA, long sourceB)
{
  byte dir = DIR_SE;
  
  // some bitchin triangles, I goshed-well love triangles.
  long diffA = sourceA - targetA;
  long diffB = sourceB - targetB;
  long hyp = sqrt(sq(diffA)+sq(diffB));
  
  float bearing = atan(hyp/diffA);
  
//  Serial.print("bearing:");
//  Serial.println(bearing);
//  
//  Serial.print(F("TargetA: "));
//  Serial.print(targetA);
//  Serial.print(F(", targetB: "));
//  Serial.print(targetB);
//  Serial.print(F(". SourceA: "));
//  Serial.print(sourceA);
//  Serial.print(F(", sourceB: "));
//  Serial.print(sourceB);
//  Serial.println(F("."));
  
  
  if (targetA<sourceA && targetB<sourceA)
  {
//    Serial.println(F("calculated NW"));
    dir = DIR_NW;
  }
  else if (targetA>sourceA && targetB>sourceB)
  {
//    Serial.println(F("calculated SE"));
    dir = DIR_SE;
  }
  else if (targetA<sourceA && targetB>sourceB)
  {
//    Serial.println(F("calculated SW"));
    dir = DIR_SW;
  }
  else if (targetA>sourceA && targetB<sourceB)
  {
//    Serial.println(F("calculated NE"));
    dir = DIR_NE;
  }
  else if (targetA==sourceA && targetB<sourceB)
  {
//    Serial.println(F("calc NE"));
    dir = DIR_NE;
  }
  else if (targetA==sourceA && targetB>sourceB)
  {
//    Serial.println(F("calc SW"));
    dir = DIR_SW;
  }
  else if (targetA<sourceA && targetB==sourceB)
  {
//    Serial.println(F("calc NW"));
    dir = DIR_NW;
  }
  else if (targetA>sourceA && targetB==sourceB)
  {
//    Serial.println(F("calc SE"));
    dir = DIR_SE;
  }
  else
  {
//    Serial.println("Not calculated - default SE");
  }

  return dir;
}

void drawScribblePixel() {
    int originA = asInt(inParam1);
    int originB = asInt(inParam2);
    int size = asInt(inParam3);
    int density = asInt(inParam4);
    
    int maxDens = maxDensity(penWidth, size);

    density = scaleDensity(density, 255, maxDens);
    drawScribblePixel(originA, originB, size*1.1, density);
    
    outputAvailableMemory(); 
}

void drawScribblePixel(long originA, long originB, int size, int density) {

//  int originA = accelA.currentPosition();
//  int originB = accelB.currentPosition();
  
  long lowLimitA = originA-(size/2);
  long highLimitA = lowLimitA+size;
  long lowLimitB = originB-(size/2);
  long highLimitB = lowLimitB+size;
  int randA;
  int randB;
  
  int inc = 0;
  int currSize = size;
  
  for (int i = 0; i <= density; i++)
  {
    randA = random(0, currSize);
    randB = random(0, currSize);
    changeLength(lowLimitA+randA, lowLimitB+randB);
    
    lowLimitA-=inc;
    highLimitA+=inc;
    currSize+=inc*2;
  }
}

int minSegmentSizeForPen(float penSize)
{
  float penSizeInSteps = penSize * stepsPerMM;

  int minSegSize = 1;
  if (penSizeInSteps >= 2.0)
    minSegSize = int(penSizeInSteps);
    
//  Serial.print(F("Min segment size for penSize "));
//  Serial.print(penSize);
//  Serial.print(F(": "));
//  Serial.print(minSegSize);
//  Serial.print(F(" steps."));
//  Serial.println();
  
  return minSegSize;
}

int maxDensity(float penSize, int rowSize)
{
  float rowSizeInMM = mmPerStep * rowSize;
//  Serial.print(F("rowsize in mm: "));
//  Serial.print(rowSizeInMM);
//  Serial.print(F(", mmPerStep: "));
//  Serial.print(mmPerStep);
//  Serial.print(F(", rowsize: "));
//  Serial.println(rowSize);
  
  float numberOfSegments = rowSizeInMM / penSize;
  int maxDens = 1;
  if (numberOfSegments >= 2.0)
    maxDens = int(numberOfSegments);
    
//  Serial.print("num of segments float:");
//  Serial.println(numberOfSegments);
//
//    
//  Serial.print(F("Max density: penSize: "));
//  Serial.print(penSize);
//  Serial.print(F(", rowSize: "));
//  Serial.print(rowSize);
//  Serial.println(maxDens);
  
  return maxDens;
}

int scaleDensity(int inDens, int inMax, int outMax)
{
  float reducedDens = (float(inDens) / float(inMax)) * float(outMax);
  reducedDens = outMax-reducedDens;
//  Serial.print(F("inDens:"));
//  Serial.print(inDens);
//  Serial.print(F(", inMax:"));
//  Serial.print(inMax);
//  Serial.print(F(", outMax:"));
//  Serial.print(outMax);
//  Serial.print(F(", reduced:"));
//  Serial.println(reducedDens);
  
  // round up if bigger than .5
  int result = int(reducedDens);
  if (reducedDens - (result) > 0.5)
    result ++;
  
  return result;
}

void drawSquarePixel(int length, int width, int density, byte drawDirection) 
{
  // work out how wide each segment should be
  int segmentLength = 0;

  if (density > 0)
  {
    // work out some segment widths
    int basicSegLength = length / density;
    int basicSegRemainder = length % density;
    float remainderPerSegment = float(basicSegRemainder) / float(density);
    float totalRemainder = 0.0;
    int lengthSoFar = 0;
    
//    Serial.print("Basic seg length:");
//    Serial.print(basicSegLength);
//    Serial.print(", basic seg remainder:");
//    Serial.print(basicSegRemainder);
//    Serial.print(", remainder per seg");
//    Serial.println(remainderPerSegment);
    
    for (int i = 0; i <= density; i++) 
    {
      totalRemainder += remainderPerSegment;

      if (totalRemainder >= 1.0)
      {
        totalRemainder -= 1.0;
        segmentLength = basicSegLength+1;
      }
      else
      {
        segmentLength = basicSegLength;
      }

      if (drawDirection == DIR_SE) {
        drawSquareWaveAlongA(width, segmentLength, density, i);
      }
      if (drawDirection == DIR_SW) {
        drawSquareWaveAlongB(width, segmentLength, density, i);
      }
      if (drawDirection == DIR_NW) {
        segmentLength = 0 - segmentLength; // reverse
        drawSquareWaveAlongA(width, segmentLength, density, i);
      }
      if (drawDirection == DIR_NE) {
        segmentLength = 0 - segmentLength; // reverse
        drawSquareWaveAlongB(width, segmentLength, density, i);
      }
      lengthSoFar += segmentLength;
    //      Serial.print("distance so far:");
    //      Serial.print(distanceSoFar);
      
      
      reportPosition();
    } // end of loop
  }
}


void drawSquareWaveAlongA(int waveAmplitude, int waveLength, int totalWaves, int waveNo)
{
  if (waveNo == 0) 
  { 
    // first one, half a line and an along
    Serial.println("First wave half");
    if (lastWaveWasTop) {
      moveB(waveAmplitude/2);
      moveA(waveLength);
    }
    else {
      moveB(0-(waveAmplitude/2));
      moveA(waveLength);
    }
    flipWaveDirection();
  }
  else if (waveNo == totalWaves) 
  { 
    // last one, half a line with no along
    if (lastWaveWasTop) {
      moveB(waveAmplitude/2);
    }
    else {
      moveB(0-(waveAmplitude/2));
    }
  }
  else 
  { 
    // intervening lines - full lines, and an along
    if (lastWaveWasTop) {
      moveB(waveAmplitude);
      moveA(waveLength);
    }
    else {
      moveB(0-waveAmplitude);
      moveA(waveLength);
    }
    flipWaveDirection();
  }
}

void drawSquareWaveAlongB(int waveAmplitude, int waveLength, int totalWaves, int waveNo)
{
  if (waveNo == 0) 
  { 
    // first one, half a line and an along
    if (lastWaveWasTop) {
      moveA(waveAmplitude/2);
      moveB(waveLength);
    }
    else {
      moveA(0-(waveAmplitude/2));
      moveB(waveLength);
    }
    flipWaveDirection();
  }
  else if (waveNo == totalWaves) 
  { 
    // last one, half a line with no along
    if (lastWaveWasTop) {
      moveA(waveAmplitude/2);
    }
    else {
      moveA(0-(waveAmplitude/2));
    }
  }
  else 
  { 
    // intervening lines - full lines, and an along
    if (lastWaveWasTop) {
      moveA(waveAmplitude);
      moveB(waveLength);
    }
    else {
      moveA(0-waveAmplitude);
      moveB(waveLength);
    }
    flipWaveDirection();
  }
}


void flipWaveDirection()
{
  if (lastWaveWasTop)
    lastWaveWasTop = false;
  else
    lastWaveWasTop = true;
}
void moveA(int dist)
{
  accelA.move(dist);
  while (accelA.distanceToGo() != 0)
  {
    accelA.run();
    refreshIndicators();
  }
}

void moveB(int dist)
{
  accelB.move(dist);
  while (accelB.distanceToGo() != 0)
  {
    accelB.run();
    refreshIndicators();
  }    
}

void reportPosition()
{
  if (reportingPosition)
  {
    Serial.print(OUT_CMD_SYNC);
    Serial.print(accelA.currentPosition());
    Serial.print(COMMA);
    Serial.print(accelB.currentPosition());
    Serial.println(CMD_END);
    
  //  int cX = getCartesianX();
  //  int cY = getCartesianY(cX, accelA.currentPosition());
  //  Serial.print(OUT_CMD_CARTESIAN);
  //  Serial.print(cX*mmPerStep);
  //  Serial.print(COMMA);
  //  Serial.print(cY*mmPerStep);
  //  Serial.println(CMD_END);
  //
    outputAvailableMemory();
  }
}


void setPosition()
{
  int targetA = asInt(inParam1);
  int targetB = asInt(inParam2);

  accelA.setCurrentPosition(targetA);
  accelB.setCurrentPosition(targetB);
  
  engageMotors();
  
  reportPosition();
  hardwareCalibrated = true;
}

void engageMotors()
{
  accelA.runToNewPosition(accelA.currentPosition()+4);
  accelB.runToNewPosition(accelB.currentPosition()+4);
  accelA.runToNewPosition(accelA.currentPosition()-4);
  accelB.runToNewPosition(accelB.currentPosition()-4);
}

void releaseMotors()
{
  penUp();
  motora.release();
  motorb.release();
  hardwareCalibrated = false;
}

float getCartesianXFP(float aPos, float bPos)
{
  float calcX = (pow(pageWidth, 2) - pow(bPos, 2) + pow(aPos, 2)) / (pageWidth*2);
  return calcX;  
}
float getCartesianYFP(float cX, float aPos) 
{
  float calcY = sqrt(pow(aPos,2)-pow(cX,2));
  return calcY;
}


int getCartesianX(float aPos, float bPos)
{
  int calcX = int((pow(pageWidth, 2) - pow(bPos, 2) + pow(aPos, 2)) / (pageWidth*2));
  return calcX;  
}

int getCartesianX() {
  int calcX = getCartesianX(accelA.currentPosition(), accelB.currentPosition());
  return calcX;  
}

int getCartesianY() {
  return getCartesianY(getCartesianX(), accelA.currentPosition());
}
int getCartesianY(int cX, float aPos) {
  int calcX = cX;
  int calcY = int(sqrt(pow(aPos,2)-pow(calcX,2)));
  return calcY;
}


void outputAvailableMemory()
{
  int avMem = availableMemory();
  if (avMem != availMem)
  {
    availMem = avMem;
    Serial.print(FREE_MEMORY_STRING);
    Serial.print(availMem);
    Serial.println(CMD_END);
  }
}

//from http://www.arduino.cc/playground/Code/AvailableMemory
int availableMemory() {
  uint8_t * heapptr, * stackptr;
  stackptr = (uint8_t *)malloc(4);
  heapptr = stackptr;
  free(stackptr);               
  stackptr = (uint8_t *)(SP);
  return stackptr - heapptr;
} 

//This function will write a 2 byte integer to the eeprom at the specified address and address + 1
void EEPROMWriteInt(int p_address, int p_value)
{
  Serial.print(F("Writing Int "));
  Serial.print(p_value);
  Serial.print(F(" to address "));
  Serial.println(p_address);

  byte lowByte = ((p_value >> 0) & 0xFF);
  byte highByte = ((p_value >> 8) & 0xFF);
  EEPROM.write(p_address, lowByte);
  EEPROM.write(p_address + 1, highByte);
}

//This function will read a 2 byte integer from the eeprom at the specified address and address + 1
unsigned int EEPROMReadInt(int p_address)
{
  byte lowByte = EEPROM.read(p_address);
  byte highByte = EEPROM.read(p_address + 1);
  return ((lowByte << 0) & 0xFF) + ((highByte << 8) & 0xFF00);
}

void initSD()
{
  pinMode(chipSelect, OUTPUT); // necessary for SD card reading to work
  // see if the card is present and can be initialized:

  // see if the card is present and can be initialized:
  if (!SD.begin(chipSelect)) {
    Serial.println("Card failed, or not present");
    // don't do anything more:
    return;
  }
  Serial.println("card initialized.");

  Serial.println("Initializing SD card...");
  // On the Ethernet Shield, CS is pin 4. It's set as an output by default.
  // Note that even if it's not used as the CS pin, the hardware SS pin 
  // (10 on most Arduino boards, 53 on the Mega) must be left as an output 
  // or the SD library functions will not work. 

  // we'll use the initialization code from the utility libraries
  // since we're just testing if the card is working!
  if (!card.init(SPI_HALF_SPEED, chipSelect)) 
  {
    Serial.println("initialization failed. Things to check:");
    Serial.println("* is a card is inserted?");
    Serial.println("* Is your wiring correct?");
    Serial.println("* did you change the chipSelect pin to match your shield or module?");
    return;
  } 
  else 
  {
   Serial.println("Wiring is correct and a card is present."); 
  }

  // print the type of card
  Serial.print("\nCard type: ");
  switch(card.type()) {
    case SD_CARD_TYPE_SD1:
      Serial.println("SD1");
      break;
    case SD_CARD_TYPE_SD2:
      Serial.println("SD2");
      break;
    case SD_CARD_TYPE_SDHC:
      Serial.println("SDHC");
      break;
    default:
      Serial.println("Unknown");
  }

  // Now we will try to open the 'volume'/'partition' - it should be FAT16 or FAT32
  if (!volume.init(card)) {
    Serial.println("Could not find FAT16/FAT32 partition.\nMake sure you've formatted the card");
    return;
  }


  // print the type and size of the first FAT-type volume
  uint32_t volumesize;
  Serial.print("\nVolume type is FAT");
  Serial.println(volume.fatType(), DEC);
  Serial.println();
  
  volumesize = volume.blocksPerCluster();    // clusters are collections of blocks
  volumesize *= volume.clusterCount();       // we'll have a lot of clusters
  volumesize *= 512;                            // SD card blocks are always 512 bytes
  Serial.print("Volume size (bytes): ");
  Serial.println(volumesize);
  Serial.print("Volume size (Kbytes): ");
  volumesize /= 1024;
  Serial.println(volumesize);
  Serial.print("Volume size (Mbytes): ");
  volumesize /= 1024;
  Serial.println(volumesize);

  
  Serial.println("\nFiles found on the card (name, date and size in bytes): ");
  root.openRoot(volume);
  
  // list all files in the card with date and size
  root.ls(LS_R | LS_DATE | LS_SIZE);
}

void storeCommand(String command)
{
  char filename[8];
  commandFilename.toCharArray(filename, commandFilename.length());
  File storeFile = SD.open("comm.txt", FILE_WRITE);
  
  // if the file opened okay, write to it:
  if (storeFile) 
  {
    Serial.print("Writing to file ");
    Serial.println(commandFilename);
    storeFile.println(command);

    // close the file:
    storeFile.close();
    Serial.println("done.");
  } 
  else 
  {
    // if the file didn't open, print an error:
    Serial.print("error opening ");
    Serial.println(commandFilename);
  }  
}

/*
http://www.excamera.com/sphinx/article-crc.html
*/
unsigned long crc_update(unsigned long crc, byte data)
{
    byte tbl_idx;
    tbl_idx = crc ^ (data >> (0 * 4));
    crc = pgm_read_dword_near(crc_table + (tbl_idx & 0x0f)) ^ (crc >> 4);
    tbl_idx = crc ^ (data >> (1 * 4));
    crc = pgm_read_dword_near(crc_table + (tbl_idx & 0x0f)) ^ (crc >> 4);
    return crc;
}

unsigned long crc_string(String s)
{
  unsigned long crc = ~0L;
  for (int i = 0; i < s.length(); i++)
  {
    crc = crc_update(crc, s.charAt(i));
  }
  crc = ~crc;
  return crc;
}
