airzone-sama/polargraph/embedded/polargraph_server_mega_mod/exec.ino

/**
*  Polargraph Server. - CORE
*  Written by Sandy Noble
*  Released under GNU License version 3.
*  http://www.polargraph.co.uk
*  http://code.google.com/p/polargraph/

Exec.

This is one of the core files for the polargraph server program.  
Purposes are getting a little more blurred here.  This file contains
the basic decision tree that branches based on command.

It has a set of the most general-purpose drawing commands, but only
methods that are directly called - none of the geometry or conversion
routines are here.

*/
/**  This method looks only for the basic command set
*/
boolean exec_executeBasicCommand(String &com)
{
  boolean executed = true;
  if (com.startsWith(CMD_CHANGELENGTH))
    exec_changeLength();
  else if (com.startsWith(CMD_CHANGELENGTHDIRECT))
    exec_changeLengthDirect();
  else if (com.startsWith(CMD_CHANGEPENWIDTH))
    exec_changePenWidth();
  else if (com.startsWith(CMD_CHANGEMOTORSPEED))
    exec_changeMotorSpeed();
  else if (com.startsWith(CMD_CHANGEMOTORACCEL))
    exec_changeMotorAcceleration();
  else if (com.startsWith(CMD_SETMOTORSPEED))
    exec_setMotorSpeed();
  else if (com.startsWith(CMD_SETMOTORACCEL))
    exec_setMotorAcceleration();
  else if (com.startsWith(CMD_DRAWPIXEL))
    pixel_drawSquarePixel();
  else if (com.startsWith(CMD_DRAWSCRIBBLEPIXEL))
    pixel_drawScribblePixel();
//  else if (com.startsWith(CMD_DRAWRECT))
//    drawRectangle();
  else if (com.startsWith(CMD_CHANGEDRAWINGDIRECTION))
    exec_changeDrawingDirection();
  else if (com.startsWith(CMD_SETPOSITION))
    exec_setPosition();
  else if (com.startsWith(CMD_TESTPENWIDTHSQUARE))
    pixel_testPenWidth();
  else if (com.startsWith(CMD_PENDOWN))
    penlift_penDown();
  else if (com.startsWith(CMD_PENUP))
    penlift_penUp();
  else if (com.startsWith(CMD_SETMACHINESIZE))
    exec_setMachineSizeFromCommand();
  else if (com.startsWith(CMD_SETMACHINENAME))
    exec_setMachineNameFromCommand();
  else if (com.startsWith(CMD_SETMACHINEMMPERREV))
    exec_setMachineMmPerRevFromCommand();
  else if (com.startsWith(CMD_SETMACHINESTEPSPERREV))
    exec_setMachineStepsPerRevFromCommand();
  else if (com.startsWith(CMD_SETMACHINESTEPMULTIPLIER))
    exec_setMachineStepMultiplierFromCommand();
  else if (com.startsWith(CMD_GETMACHINEDETAILS))
    exec_reportMachineSpec();
  else if (com.startsWith(CMD_RESETEEPROM))
    eeprom_resetEeprom();
  else
    executed = false;

  return executed;
}

void exec_changeDrawingDirection() 
{
  globalDrawDirectionMode = asInt(inParam1);
  globalDrawDirection = asInt(inParam2);
  Michael_SerialPrint(F("Changed draw direction mode to be "));
  Michael_SerialPrint(globalDrawDirectionMode);
  Michael_SerialPrint(F(" and direction is "));
  Michael_SerialPrintln(globalDrawDirection);
}


void exec_reportMachineSpec()
{
  eeprom_dumpEeprom();
  Michael_SerialPrint(F("PGNAME,"));
  Michael_SerialPrint(machineName);
  Michael_SerialPrintln(CMD_END);
  
  Michael_SerialPrint(F("PGSIZE,"));
  Michael_SerialPrint(machineWidth);
  Michael_SerialPrint(COMMA);
  Michael_SerialPrint(machineHeight);
  Michael_SerialPrintln(CMD_END);

  Michael_SerialPrint(F("PGMMPERREV,"));
  Michael_SerialPrint(mmPerRev);
  Michael_SerialPrintln(CMD_END);

  Michael_SerialPrint(F("PGSTEPSPERREV,"));
  Michael_SerialPrint(motorStepsPerRev);
  Michael_SerialPrintln(CMD_END);
  
  Michael_SerialPrint(F("PGSTEPMULTIPLIER,"));
  Michael_SerialPrint(stepMultiplier);
  Michael_SerialPrintln(CMD_END);

}

void exec_setMachineSizeFromCommand()
{
  int width = asInt(inParam1);
  int height = asInt(inParam2);
  
  if (width > 10)
  {
    eeprom_EEPROMWriteInt(EEPROM_MACHINE_WIDTH, width);
  }
  if (height > 10)
  {
    eeprom_EEPROMWriteInt(EEPROM_MACHINE_HEIGHT, height);
  }

  eeprom_loadMachineSpecFromEeprom();
}
void exec_setMachineNameFromCommand()
{
  String name = inParam1;
  if (name != DEFAULT_MACHINE_NAME)
  {
    for (int i = 0; i < 8; i++)
    {
      EEPROM.write(EEPROM_MACHINE_NAME+i, name[i]);
    }
  }
  eeprom_loadMachineSpecFromEeprom();
}

void exec_setMachineMmPerRevFromCommand()
{
  float mmPerRev = asFloat(inParam1);
  eeprom_EEPROMWriteInt(EEPROM_MACHINE_MM_PER_REV, mmPerRev);
  eeprom_loadMachineSpecFromEeprom();
}
void exec_setMachineStepsPerRevFromCommand()
{
  int stepsPerRev = asInt(inParam1);
  eeprom_EEPROMWriteInt(EEPROM_MACHINE_STEPS_PER_REV, stepsPerRev);
  eeprom_loadMachineSpecFromEeprom();
}

void exec_setMachineStepMultiplierFromCommand()
{
  eeprom_EEPROMWriteInt(EEPROM_MACHINE_STEP_MULTIPLIER, asInt(inParam1));
  eeprom_loadMachineSpecFromEeprom();
}

void exec_setMotorSpeed()
{
  exec_setMotorSpeed(asFloat(inParam1));
}

void exec_setMotorSpeed(float speed)
{
  currentMaxSpeed = speed;
  motorA.setMaxSpeed(currentMaxSpeed);
  motorB.setMaxSpeed(currentMaxSpeed);
  Michael_SerialPrint(F("New max speed: "));
  Michael_SerialPrintln(currentMaxSpeed);
}

void exec_changeMotorSpeed()
{
  float speedChange = asFloat(inParam1);
  float newSpeed = currentMaxSpeed + speedChange;
  exec_setMotorSpeed(newSpeed);
}


 
void exec_setMotorAcceleration()
{
  exec_setMotorAcceleration(asFloat(inParam1));
}
void exec_setMotorAcceleration(float accel)
{
  currentAcceleration = accel;
  motorA.setAcceleration(currentAcceleration);
  motorB.setAcceleration(currentAcceleration);
  Michael_SerialPrint(F("New acceleration: "));
  Michael_SerialPrintln(currentAcceleration);
}
void exec_changeMotorAcceleration()
{
  float speedChange = asFloat(inParam1);
  float newAccel = currentAcceleration + speedChange;
  exec_setMotorAcceleration(newAccel);
}

void exec_changePenWidth()
{
  penWidth = asFloat(inParam1);
  Michael_SerialPrint(F("Changed Pen width to "));
  Michael_SerialPrint(penWidth);
  Michael_SerialPrint(F("mm"));
  Michael_SerialPrintln();
}

void exec_setPosition()
{
  long targetA = multiplier(asLong(inParam1));
  long targetB = multiplier(asLong(inParam2));

  motorA.setCurrentPosition(targetA);
  motorB.setCurrentPosition(targetB);
  
  engageMotors();
  
  reportPosition();
}

void exec_changeLengthRelative()
{
  long lenA = multiplier(asLong(inParam1));
  long lenB = multiplier(asLong(inParam2));
  
  changeLengthRelative(lenA, lenB);
}  

void exec_changeLength()
{
  float lenA = multiplier(asFloat(inParam1));
  float lenB = multiplier(asFloat(inParam2));
  
  changeLength(lenA, lenB);
}

void exec_changeLengthDirect()
{
  float endA = multiplier(asFloat(inParam1));
  float endB = multiplier(asFloat(inParam2));
  int maxSegmentLength = asInt(inParam3);

  float startA = motorA.currentPosition();
  float startB = motorB.currentPosition();

  if (endA < 20 || endB < 20 || endA > getMaxLength() || endB > getMaxLength())
  {
    Michael_SerialPrintln("This point falls outside the area of this machine. Skipping it.");
  }
  else
  {
  Michael_SerialPrintln("dr.5");
    exec_drawBetweenPoints(startA, startB, endA, endB, maxSegmentLength);
  }
}  

/**
This moves the gondola in a straight line between p1 and p2.  Both input coordinates are in 
the native coordinates system.  

The fidelity of the line is controlled by maxLength - this is the longest size a line segment is 
allowed to be.  1 is finest, slowest.  Use higher values for faster, wobblier.
*/
void exec_drawBetweenPoints(float p1a, float p1b, float p2a, float p2b, int maxSegmentLength)
{
  // ok, we're going to plot some dots between p1 and p2.  Using maths. I know! Brave new world etc.
  
  // First, convert these values to cartesian coordinates
  // We're going to figure out how many segments the line
  // needs chopping into.
  float c1x = getCartesianXFP(p1a, p1b);
  float c1y = getCartesianYFP(c1x, p1a);
  
  float c2x = getCartesianXFP(p2a, p2b);
  float c2y = getCartesianYFP(c2x, p2a);
  
  // test to see if it's on the page
  if (c2x > 20 && c2x<pageWidth-20 && c2y > 20 && c2y <pageHeight-20)
  {
    reportingPosition = false;
    float deltaX = c2x-c1x;    // distance each must move (signed)
    float deltaY = c2y-c1y;
    float totalDistance = sqrt(sq(deltaX) + sq(deltaY));

    int linesegs = 1;            // assume at least 1 line segment will get us there.
    if (abs(deltaX) > abs(deltaY))
    {
      // slope <=1 case    
      while ((abs(deltaX)/linesegs) > maxSegmentLength)
      {
        linesegs++;
      }
    }
    else
    {
      // slope >1 case
      while ((abs(deltaY)/linesegs) > maxSegmentLength)
      {
        linesegs++;
      }
    }
    
    // reduce delta to one line segments' worth.
    deltaX = deltaX/linesegs;
    deltaY = deltaY/linesegs;
  
    // render the line in N shorter segments
    long runSpeed = 0;

    usingAcceleration = false;
    while (linesegs > 0)
    {
      // compute next new location
      c1x = c1x + deltaX;
      c1y = c1y + deltaY;
  
      // convert back to machine space
      float pA = getMachineA(c1x, c1y);
      float pB = getMachineB(c1x, c1y);
    
      // do the move
      runSpeed = desiredSpeed(linesegs, runSpeed, currentAcceleration*4);
      
//      Serial.print("Runspeed:");
//      Serial.println(runSpeed);
      
      motorA.setSpeed(runSpeed);
      motorB.setSpeed(runSpeed);
      changeLength(pA, pB);
  
      // one line less to do!
      linesegs--;
    }
    
    // do the end point in case theres been some rounding errors etc
    motorA.setSpeed(0);
    motorB.setSpeed(0);
    reportingPosition = true;
    changeLength(p2a, p2b);
    
    usingAcceleration = true;
  }
  else
  {
    Michael_SerialPrintln("Line is not on the page. Skipping it.");
  }
  outputAvailableMemory();
}

// Work out and return a new speed.
// Subclasses can override if they want
// Implement acceleration, deceleration and max speed
// Negative speed is anticlockwise
// This is called:
//  after each step
//  after user changes:
//   maxSpeed
//   acceleration
//   target position (relative or absolute)
float desiredSpeed(long distanceTo, float currentSpeed, float acceleration)
{
    float requiredSpeed;

    if (distanceTo == 0)
	return 0.0f; // We're there

    // sqrSpeed is the signed square of currentSpeed.
    float sqrSpeed = sq(currentSpeed);
    if (currentSpeed < 0.0)
      sqrSpeed = -sqrSpeed;
      
    float twoa = 2.0f * acceleration; // 2ag
    
    // if v^^2/2as is the the left of target, we will arrive at 0 speed too far -ve, need to accelerate clockwise
    if ((sqrSpeed / twoa) < distanceTo)
    {
	// Accelerate clockwise
	// Need to accelerate in clockwise direction
	if (currentSpeed == 0.0f)
	    requiredSpeed = sqrt(twoa);
	else
	    requiredSpeed = currentSpeed + fabs(acceleration / currentSpeed);

	if (requiredSpeed > currentMaxSpeed)
	    requiredSpeed = currentMaxSpeed;
    }
    else
    {
	// Decelerate clockwise, accelerate anticlockwise
	// Need to accelerate in clockwise direction
	if (currentSpeed == 0.0f)
	    requiredSpeed = -sqrt(twoa);
	else
	    requiredSpeed = currentSpeed - fabs(acceleration / currentSpeed);
	if (requiredSpeed < -currentMaxSpeed)
	    requiredSpeed = -currentMaxSpeed;
    }
    
    //Serial.println(requiredSpeed);
    return requiredSpeed;
}
