airzone-sama/polargraph/embedded/polargraph_server_mega_mod/sd.ino

/**
*  Polargraph Server for ATMEGA1280+ 
*  Written by Sandy Noble
*  Released under GNU License version 3.
*  http://www.polargraph.co.uk
*  http://code.google.com/p/polargraph/

Specific features for Polarshield / arduino mega.
SD.

For initialising, reading and writing the SD card data store.

*/

/*  ==============================================================
    Processing the SD card if there is one attached. 
=================================================================*/

void sd_initSD()
{
  pinMode(chipSelect, OUTPUT); // necessary for SD card reading to work
  // see if the card is present and can be initialized:

  // see if the card is present and can be initialized:
  //if (!SD.begin(chipSelect)) {
  //  Michael_SerialPrintln("Card failed, or not present");
    // don't do anything more:
  //  return;
  //}
  //Michael_SerialPrintln("card initialized.");

  Michael_SerialPrintln("Initializing SD card...");
  // On the Ethernet Shield, CS is pin 4. It's set as an output by default.
  // Note that even if it's not used as the CS pin, the hardware SS pin 
  // (10 on most Arduino boards, 53 on the Mega) must be left as an output 
  // or the SD library functions will not work. 

  // we'll use the initialization code from the utility libraries
  // since we're just testing if the card is working!
  if (!SD.card.init(SPI_HALF_SPEED, chipSelect)) 
  {
    Michael_SerialPrintln("initialization failed. Things to check:");
    Michael_SerialPrintln("* is a card is inserted?");
    Michael_SerialPrintln("* Is your wiring correct?");
    Michael_SerialPrintln("* did you change the chipSelect pin to match your shield or module?");
    return;
  } 
  else 
  {
   Michael_SerialPrintln("Wiring is correct and a card is present."); 
  }

  // print the type of card
  Michael_SerialPrint("\nCard type: ");
  switch(SD.card.type()) {
    case SD_CARD_TYPE_SD1:
      Michael_SerialPrintln("SD1");
      break;
    case SD_CARD_TYPE_SD2:
      Michael_SerialPrintln("SD2");
      break;
    case SD_CARD_TYPE_SDHC:
      Michael_SerialPrintln("SDHC");
      break;
    default:
      Michael_SerialPrintln("Unknown");
  }

  // Now we will try to open the 'volume'/'partition' - it should be FAT16 or FAT32
  if (!SD.volume.init(SD.card)) {
    Michael_SerialPrintln("Could not find FAT16/FAT32 partition.\nMake sure you've formatted the card");
    return;
  }


  // print the type and size of the first FAT-type volume
  uint32_t volumesize;
  Michael_SerialPrint("\nVolume type is FAT");
  Michael_SerialPrintln(SD.volume.fatType(), DEC);
  Michael_SerialPrintln();
  
  volumesize = SD.volume.blocksPerCluster();    // clusters are collections of blocks
  volumesize *= SD.volume.clusterCount();       // we'll have a lot of clusters
  volumesize *= 512;                            // SD card blocks are always 512 bytes
  Michael_SerialPrint("Volume size (bytes): ");
  Michael_SerialPrintln(volumesize);
  Michael_SerialPrint("Volume size (Kbytes): ");
  volumesize /= 1024;
  Michael_SerialPrintln(volumesize);
  Michael_SerialPrint("Volume size (Mbytes): ");
  volumesize /= 1024;
  Michael_SerialPrintln(volumesize);

  
  Michael_SerialPrintln("\nFiles found on the card (name, date and size in bytes): ");
  SD.root.openRoot(SD.volume);
  
  // list all files in the card with date and size
  SD.root.ls(LS_R | LS_DATE | LS_SIZE);
}

void sd_storeCommand(String command)
{
  // delete file if it exists
  char filename[commandFilename.length()+1];
  commandFilename.toCharArray(filename, commandFilename.length()+1);

  File storeFile = SD.open(filename, FILE_WRITE);
  
  // if the file opened okay, write to it:
  if (storeFile) 
  {
    Michael_SerialPrint("Writing to file ");
    Michael_SerialPrintln(commandFilename);
    storeFile.println(command);

    // close the file:
    storeFile.close();
    Michael_SerialPrintln("done.");
  } 
  else 
  {
    // if the file didn't open, print an error:
    Michael_SerialPrint("error opening ");
    Michael_SerialPrintln(commandFilename);
  }  
}

/**
*  Most of this bmp image opening / handling stuff only slightly adapted from
*  Adafruit's marvellous stuff.  Seriously, is there anything adafruit
*  doesn't do slightly better than anyone else?
https://github.com/adafruit/TFTLCD-Library/blob/master/examples/tftbmp/tftbmp.pde
*/

boolean sd_openPbm(String pbmFilename)
{
  char filename[pbmFilename.length()+1];
  pbmFilename.toCharArray(filename, pbmFilename.length()+1);  
  pbmFile = SD.open(filename, FILE_READ);

  if (! pbmFile) 
  {
    Michael_SerialPrintln("didnt find image");
    return false;
  }
  
  if (! sd_pbmReadHeader()) 
  { 
     Michael_SerialPrintln("bad pbm");
     return false;
  }
  
  pbmFileLength = pbmFile.size();
  
  return true;
}

byte sd_getBrightnessAtPixel(int x, int y) 
{
  Michael_SerialPrint("Pixel x:");
  Michael_SerialPrint(x);
  Michael_SerialPrint(", y:");
  Michael_SerialPrintln(y);
  
  Michael_SerialPrint("PbmImageOffset:");
  Michael_SerialPrintln(pbmImageoffset);
  Michael_SerialPrint("pbmWidth:");
  Michael_SerialPrintln(pbmWidth);
  
  long addressToSeek = (pbmImageoffset + (y * pbmWidth) + x);
  Michael_SerialPrint("Address:");
  Michael_SerialPrint(addressToSeek);
  if (addressToSeek > pbmFileLength)
  {
    return -1;
  }
  else
  {
    pbmFile.seek(addressToSeek);
    byte pixelValue = pbmFile.read();
    Michael_SerialPrint(", Pixel value:");
    Michael_SerialPrintln(pixelValue);
    return pixelValue;
  }
}

boolean sd_pbmReadHeader() 
{
  pbmFile.seek(0);
  // read header
  char buf;
  String magicNumber = "  ";
  buf = pbmFile.read();
  magicNumber[0] = buf;
  
  buf = pbmFile.read();
  magicNumber[1] = buf;
  
  if (magicNumber != "P5")
  {
    Michael_SerialPrint("This isn't a P5 file. It's a ");
    Michael_SerialPrint(magicNumber);
    Michael_SerialPrintln(" file, and that's no good.");
    return false;
  }
  else
    Michael_SerialPrintln("This is a very good file Herr Doktor!");
  
  buf = pbmFile.read(); // this is a blank

  // get image width
  String numberString = "";
  buf = pbmFile.read();
  
  // photoshop puts a linebreak (0A) inbetween the width & height,
  // GIMP puts a space (20).
  while (buf != 0x0A && buf != 0x20) 
  {
    // check for comments, these start with a # - hex 23
    if (buf == 0x23)
    {
      while (buf != 0x0A)
        buf = pbmFile.read(); // just loop through until we get to the end of the comment
    }

    numberString = numberString + buf;
    buf = pbmFile.read();
  }
  
  Michael_SerialPrint("PBM width:");
  Michael_SerialPrintln(numberString);
  
  char paramChar[numberString.length() + 1];
  numberString.toCharArray(paramChar, numberString.length() + 1);
  pbmWidth = atoi(paramChar);
  
  if (pbmWidth < 10)
  {
    Michael_SerialPrintln(F("PBM image must be at least 10 pixels wide."));
    return false;
  }

  // get image height
  numberString = "";
  buf = pbmFile.read();
  while (buf != 0x0A)
  {
    // check for comments, these start with a # - hex 23
    if (buf == 0x23)
    {
      while (buf != 0x0A)
        buf = pbmFile.read(); // just loop through until we get to the end of the comment
    }
    numberString = numberString + buf;
    buf = pbmFile.read();
  }
  
  Michael_SerialPrint("PBM height:");
  Michael_SerialPrintln(numberString);
  
  paramChar[numberString.length() + 1];
  numberString.toCharArray(paramChar, numberString.length() + 1);
  pbmHeight = atoi(paramChar);
  
  // work out aspect ratio
  pbmAspectRatio = float(pbmHeight) / float(pbmWidth);
  Michael_SerialPrint("PBM aspect ratio:");
  Michael_SerialPrintln(pbmAspectRatio);

  // get image depth
  numberString = "";
  buf = pbmFile.read();
  while (buf != 0x0A)
  {
    numberString = numberString + buf;
    buf = pbmFile.read();
  }
  
  Michael_SerialPrint("Numberstring depth:");
  Michael_SerialPrintln(numberString);
  
  paramChar[numberString.length() + 1];
  numberString.toCharArray(paramChar, numberString.length() + 1);
  pbmDepth = atoi(paramChar);

  pbmImageoffset = pbmFile.position();
  Michael_SerialPrint("Image offset:");
  Michael_SerialPrintln(pbmImageoffset);

  return true;
}
