airzone-sama/polargraph/embedded/polargraph_server_mega_mod/sprite.ino

/**
*  Polargraph Server for ATMEGA1280+ 
*  Written by Sandy Noble
*  Released under GNU License version 3.
*  http://www.polargraph.co.uk
*  http://code.google.com/p/polargraph/

Specific features for Polarshield / arduino mega.
Sprite.

Methods that handle drawing and processing vector sprites.

*/

void sprite_drawSprite()
{
  int spriteScale = asInt(inParam1);
  String spriteFilename = inParam2;

  // flip just B axis to orientate for SE drawing  
  int spriteScaleX = spriteScale;
  int spriteScaleY = -spriteScale;
  int rotation = 0;
  
  // and work out rotation value
  if (globalDrawDirection == DIR_SE) // 2
  {
    rotation = 0;
  }
  else if (globalDrawDirection == DIR_NW) // 4
  {
    rotation = 180;
  }
  else if (globalDrawDirection == DIR_SW) //3
  {
    rotation = 90;
  }
  else //(drawDirection == DIR_NE) // default //1
  {
    rotation = 270;
  }
  
  boolean okToDraw = false;
  if (useRoveArea)
  {
    Michael_SerialPrintln("Must use rove area.");
    // if you're using the rove area, then make sure it's in it before drawing
    if (rove_inRoveArea(motorA.currentPosition(), motorB.currentPosition()))
    {
      Michael_SerialPrintln("You're already in the rove area!");
      okToDraw = true;
    }
    else
    {
      Michael_SerialPrintln("You're outside of the rove area!");
      // if drawing text then move to the next line
      if (textRowSize > 1)
      {
        Michael_SerialPrintln("Using text rows.");
        // drawing text
        // so work out the beginning of the next line
        boolean nextLine = rove_moveToBeginningOfNextTextLine();
        Michael_SerialPrint("Next line calculated:");
        Michael_SerialPrintln(nextLine);
        
        if (nextLine)
          okToDraw = true;
      }
      else // not drawing text
      {
        Michael_SerialPrintln("Not drawing text, AND outside the rove area.");
      }
    }
  }
  else
  {
    Michael_SerialPrintln("Ok to draw - no roving.");
    // otherwise just draw it here
    okToDraw = true;
  }
  
  if (okToDraw)
    sprite_drawSprite(spriteScaleX, spriteScaleY, rotation, spriteFilename);
}

void sprite_drawSprite(int sX, int sY, int rotation, String filename)
{
  Michael_SerialPrintln("Draw sprite.");
  
  
  
  
  // save the old settings
  float oldTranslateX = translateX;
  float oldTranslateY = translateY;
  float oldScaleX = scaleX;
  float oldScaleY = scaleY;
  int oldRotation = rotateTransform;
  
//  Serial.print("1.ScaleX:");
//  Serial.println(scaleX);
//  Serial.print("1.translateX:");
//  Serial.println(translateX);

  // apply the transform parameters
  translateX = motorA.currentPosition();
  translateY = motorB.currentPosition();
  scaleX = sX;
  scaleY = sY;
  rotateTransform = rotation;

//  Serial.print("2.ScaleX:");
//  Serial.println(scaleX);
//  Serial.print("2.translateX:");
//  Serial.println(translateX);
  
  
  
  // open the file
  currentlyDrawingFromFile = true;
  impl_exec_execFromStore(filename);

  
  // undo the transformation
  translateX = oldTranslateX;
  translateY = oldTranslateY;
  scaleX = oldScaleX;
  scaleY = oldScaleY;
  rotateTransform = oldRotation;
}

void sprite_drawRandomPositionedSprite()
{
  Michael_SerialPrintln("This doesn't work yet.");
}
