airzone-sama/polargraph/embedded/polargraph_server_mega_mod/calibrate.ino

/**
*  Polargraph Server for ATMEGA1280+ 
*  Written by Sandy Noble
*  Released under GNU License version 3.
*  http://www.polargraph.co.uk
*  http://code.google.com/p/polargraph/

Specific features for Polarshield / arduino mega.
Calibration.

Experimental calibration routine.  It is designed to work with
limit switches, triggered by the gondola being a fixed (known)
distance from the sprocket.

*/

/* =============================================================================
   Here is the calibration routines
   =============================================================================*/
   
void calibrate_doCalibration()
{
  Michael_SerialPrintln("Doing calibration.");
  // raise pen
  penlift_penUp();
  // turn motors off
  releaseMotors();
  // energise motora
  motorA.enableOutputs();
  motorA.setCurrentPosition(0);
  // get a baseline from the endstop detector in case it's already at the stop
  byte endStopSignal = digitalRead(ENDSTOP_X_MIN);
  Michael_SerialPrint("Endstop:");
  Michael_SerialPrintln(endStopSignal);
  motorA.setAcceleration(10000);
  if (endStopSignal == 0)
  {
    // it's already there! God what a mess!
    // what we'll do is wind forwards until it changes back
    Michael_SerialPrintln("Already 0");
    while (endStopSignal == 0)
    {
      motorA.move(stepMultiplier);
      while (motorA.distanceToGo() != 0)
        motorA.run();
      endStopSignal = digitalRead(ENDSTOP_X_MIN);
      Michael_SerialPrintln(endStopSignal);
    }
    // then jump a bit more - one rev
    motorA.move(stepMultiplier * motorStepsPerRev);
    while (motorA.distanceToGo() != 0)
      motorA.run();
  }
  delay(400);

  // so wind backwards until hitting the stop.
  while (endStopSignal != 0)
  {
    motorA.move(-1);
    while (motorA.distanceToGo() != 0)
      motorA.run();
    endStopSignal = digitalRead(ENDSTOP_X_MIN);
  }
  Michael_SerialPrintln("A End stop signalled");
  motorARestPoint = abs(motorA.currentPosition()) + (ENDSTOP_X_MIN_POSITION * stepsPerMM);
  motorA.setCurrentPosition(ENDSTOP_X_MIN_POSITION * stepsPerMM);
  delay(1000);
  
  // wind out a machines-width of cord from motorA
  motorA.moveTo(pageWidth);
  motorA.setAcceleration(currentAcceleration);
  while (motorA.distanceToGo() != 0)
    motorA.run();
    
  // now do above for motorB
  motorB.enableOutputs();
  motorB.setCurrentPosition(0);
  motorB.setAcceleration(10000);
  // get a baseline from the endstop detector in case it's already at the stop
  endStopSignal = digitalRead(ENDSTOP_Y_MIN);
  if (endStopSignal == 0)
  {
    // it's already there! God what a mess!
    // what we'll do is wind forwards until it changes back
    while (endStopSignal == 0)
    {
      motorB.move(stepMultiplier);
      while (motorB.distanceToGo() != 0)
        motorB.run();
      endStopSignal = digitalRead(ENDSTOP_Y_MIN);
    }
    // then jump a bit more - one rev
    motorB.move(stepMultiplier * motorStepsPerRev);
    while (motorB.distanceToGo() != 0)
      motorB.run();
  }

  delay(400);
  while (endStopSignal != 0)
  {
    motorB.move(-1);
    while (motorB.distanceToGo() != 0)
      motorB.run();
    endStopSignal = digitalRead(ENDSTOP_Y_MIN);
  }
  Michael_SerialPrintln("B End stop signalled");
  motorBRestPoint = abs(motorB.currentPosition()) + (ENDSTOP_Y_MIN_POSITION * stepsPerMM);
  motorB.setCurrentPosition(ENDSTOP_Y_MIN_POSITION * stepsPerMM);

  reportPosition();
  
  // now return to the place where you started.
  
  motorA.setMaxSpeed(currentMaxSpeed);
  motorB.setMaxSpeed(currentMaxSpeed);
  motorA.setAcceleration(currentAcceleration);
  motorB.setAcceleration(currentAcceleration);

  motorA.moveTo(motorARestPoint);
  motorB.moveTo(motorBRestPoint);
  
  while (motorA.distanceToGo() != 0 || motorB.distanceToGo() != 0)
  {
    motorA.run();
    motorB.run();
  }

  reportPosition();
  powerIsOn = true;
  isCalibrated = true;
  
}
