airzone-sama/polargraph/(commit log)

2013-02-16 Initial import of SVN project
    Didn't bother with history.
    [polarshield v1.2 2012.11.02.brd, polarshield v1.2 2012.11.02.sch, polarshield v1.21 2012.11.18.brd, polarshield v1.21 2012.11.18.sch]
2013-02-16 Michael Mod
    Add:
    Pause / Resume button
    Pen Control button
    Home button
    Re-initialise SD button
    Exec comm.txt button
    Bluetooth control on Serial 3.
    This is for a Mega board
